sq43793911/Masterarbeit_public/README.md

# 硕士论文

# 高速切削加工中基于偏心误差影响的铣削刀柄的实验和模拟模态分析

对高速切削加工中铣削刀柄的弯曲振动进行了模态分析，并分析了偏心误差对于结构固有频率的影响。通过学习非线性有限元的基本方法，提出了对于高速运动物体的模态分析的行之有效的方法，独立完成了非线性有限元的模态分析的建模，并学习了模态分析的实验研究方法和常用实验软件的使用方法。

仿真模型使用Matlab 进行构建，并与Ansys 结果进行比较分析。使用Solidworks 进行实验用零件的绘制，使用PULSE LabShop 和ME’scopeVES 进行实验的测量和分析。

# Masterarbeit an TU Freiberg

Experimentelle und simulative Modalanalyse eines Werkzeugschaftes beim HSC-Fräsen und Einfluss eines Exzentrizitätsfehlers.

# Aufgabenstellung: 

Im Rahmen der ausgeschriebenen Arbeit ist das dynamische Verhalten eines Werkzeugschaftes beim HSC-Fräsen zu untersuchen. Der Einfluss einer Unwucht (Exzentrizität) soll dabei im Vordergrund stehen. Neben der Simulation soll auch eine experimentelle Untersuchung erfolgen. Dazu ist eine Versuchsvorrichtung zu konstruieren, zu fertigen und in Betrieb zu nehmen.

# Teilaufgaben:

1. Einarbeitung in das Thema simulative und experimentelle Modalanalyse

2. Erstellung eines Programmes oder einer Berechnungsvorschrift zur simulativen Modalanalyse

3. Konstruktion, Fertigung und Inbetriebnahme eines Versuchsstandes zur experimentellen Modalanalyse

4. Schriftliche Dokumentation der Arbeit

5. Erstellung eines Poster zum Inhalt der Arbeit
