sq43793911/Masterarbeit_public/n.linear FEM/Schaft_10x8-Schaft_10x8_0N-1.docx

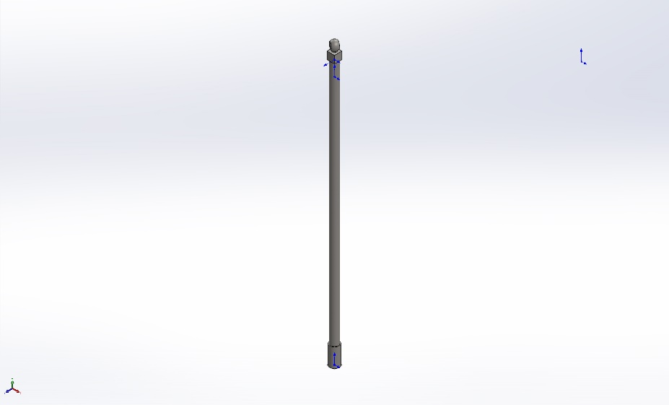
[picture p1: figure]

Simulation of Schaft_10x8

Date: 06.03.2020
Designer: Solidworks

Study name: Schaft_10x8_0N

Analysis type: Frequency
Description No Data

# Assumptions

# Model Information

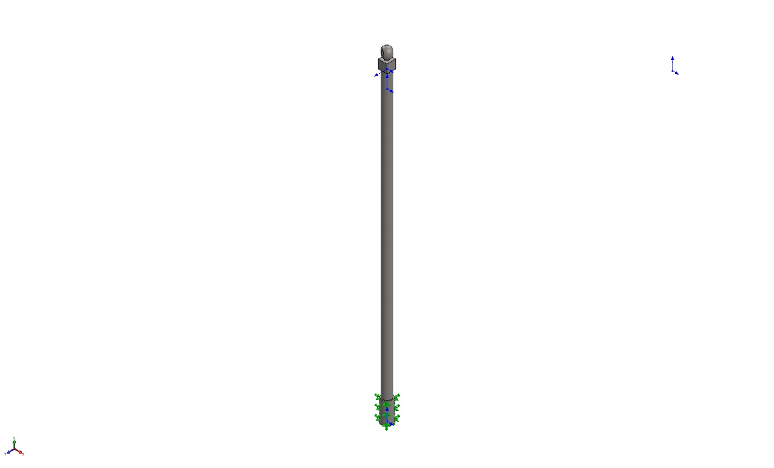
[picture p2: figure]

Model name: Schaft_10x8

Current Configuration: Default

Solid Bodies
Document Name and Reference | Treated As | Volumetric Properties | Document Path/Date Modified

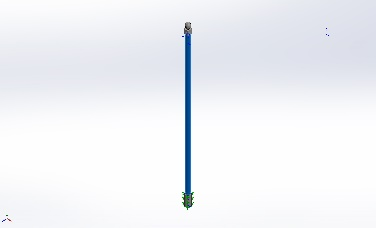
[picture p3: figure]

Aufsatz-Linear austragen1 | Solid Body | Mass:0.0727781 kg Volume:9.33053e-06 m^3 Density:7800 kg/m^3 Weight:0.713226 N | C:\Users\sq437\Desktop\Masterarbeit\BauV2018\Schaft Ra10mm Ri8mm.SLDPRT Mar 6 13:01:30 2020

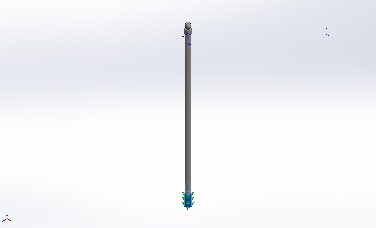
[picture p4: figure]

Rotation3 | Solid Body | Mass:0.0298954 kg Volume:3.83274e-06 m^3 Density:7800 kg/m^3 Weight:0.292975 N | C:\Users\sq437\Desktop\Masterarbeit\BauV2018\Stopfen Schaft Lagerung Var2.SLDPRT Mar 6 13:01:24 2020

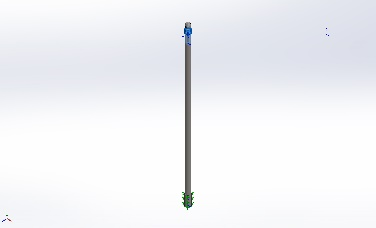
[picture p5: figure]

Cut-Extrude1 | Solid Body | Mass:0.0110468 kg Volume:1.41626e-06 m^3 Density:7800 kg/m^3 Weight:0.108259 N | C:\Users\sq437\Desktop\Masterarbeit\BauV2018\Stopfen Schaft Ringschraube Var2 ohne schrauben.SLDPRT Mar 6 13:09:47 2020

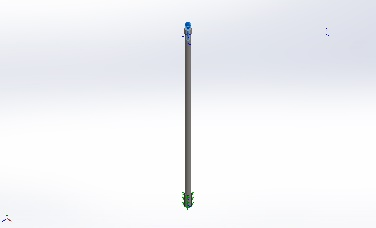
[picture p6: figure]

Fillet1 | Solid Body | Mass:0.00792918 kg Volume:1.09368e-06 m^3 Density:7250 kg/m^3 Weight:0.077706 N | C:\SOLIDWORKS Data\browser\DIN\bolts and screws\miscellaneous\eyebolt_din.sldprt Mar 6 12:38:14 2020

# Study Properties

Study name | Schaft_10x8_0N
Analysis type | Frequency
Mesh type | Solid Mesh
Number of frequencies | 5
Solver type | FFEPlus
Soft Spring: | Off
Incompatible bonding options | Automatic
Thermal option | Include temperature loads
Zero strain temperature | 298 Kelvin
Include fluid pressure effects from SOLIDWORKS Flow Simulation | Off
Result folder | SOLIDWORKS document (C:\Users\sq437\Desktop\Masterarbeit\BauV2018)

# Units

Unit system: | SI (MKS)
Length/Displacement | mm
Temperature | Kelvin
Angular velocity | Rad/sec
Pressure/Stress | N/m^2

# Material Properties

Model Reference | Properties | Components

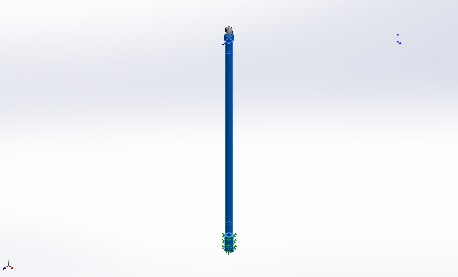
[picture p7: figure]

| Name: 1.0114 (S235J0) Model type: Linear Elastic Isotropic Default failure criterion: Max von Mises Stress Yield strength: 2.35e+08 N/m^2 Tensile strength: 3.6e+08 N/m^2 Mass density: 7800 kg/m^3 Elastic modulus: 2.1e+11 N/m^2 Poisson's ratio: 0.28 Thermal expansion coefficient: 1.1e-05 /Kelvin | SolidBody 1(Aufsatz-Linear austragen1)(Schaft Ra10mm Ri8mm-1), SolidBody 1(Rotation3)(Stopfen Schaft Lagerung Var2-1), SolidBody 1(Cut-Extrude1)(Stopfen Schaft Ringschraube Var2 ohne schrauben-1)

Curve Data:N/A

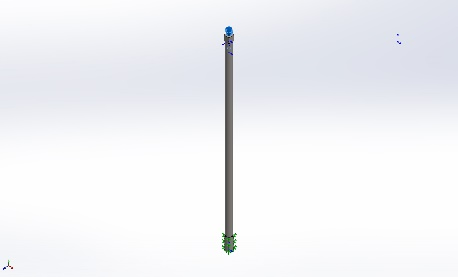
[picture p8: figure]

| Name: 1.0420 (G200) Model type: Linear Elastic Isotropic Default failure criterion: Max von Mises Stress Yield strength: 2e+08 N/m^2 Tensile strength: 3.8e+08 N/m^2 Mass density: 7250 kg/m^3 Elastic modulus: 2.1e+11 N/m^2 Poisson's ratio: 0.26 Thermal expansion coefficient: 1.15e-05 /Kelvin | SolidBody 1(Fillet1)(eyebolt_din-1)

Curve Data:N/A

# Loads and Fixtures

Fixture name | Fixture Image | Fixture Details

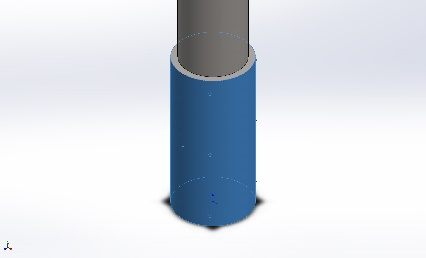
[picture p9: figure]

Fixed-1 | | Entities: 1 face(s) Type: Fixed Geometry

# Connector Definitions

No Data

# Contact Information

Contact | Contact Image | Contact Properties

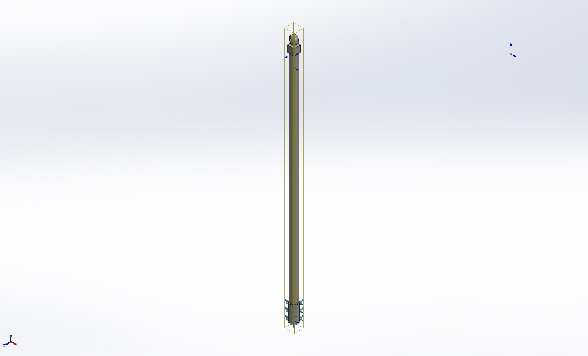
[picture p10: figure]

Global Contact | | Type: Bonded Components: 1 component(s) Options: Compatible mesh

# Mesh information

Mesh type | Solid Mesh
Mesher Used: | Standard mesh
Automatic Transition: | Off
Include Mesh Auto Loops: | Off
Jacobian points | 4 Points
Element Size | 1.51045 mm
Tolerance | 0.0755227 mm
Mesh Quality Plot | High
Remesh failed parts with incompatible mesh | Off

## Mesh information - Details

Total Nodes | 69886
Total Elements | 38733
Maximum Aspect Ratio | 9.0152
% of elements with Aspect Ratio < 3 | 99.2
% of elements with Aspect Ratio > 10 | 0
% of distorted elements(Jacobian) | 0
Time to complete mesh(hh;mm;ss): | 00:00:10
Computer name: | QX2021

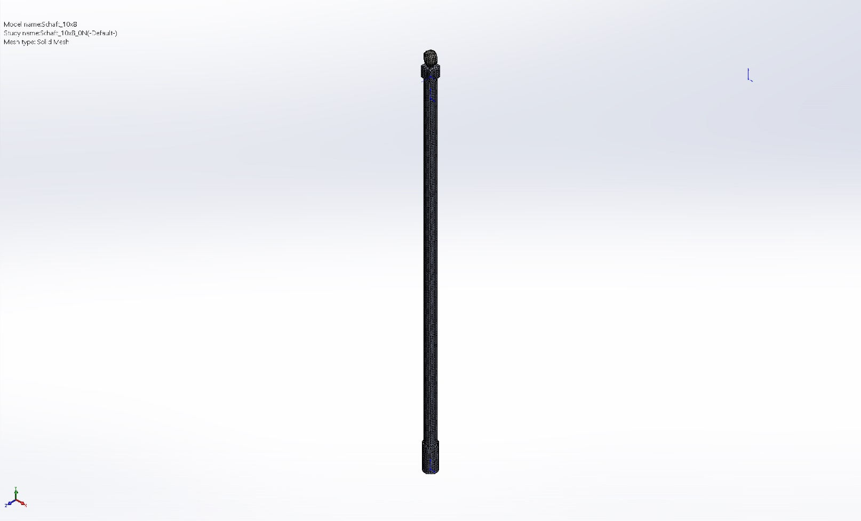
[picture p11: figure]

# Sensor Details

No Data

# Study Results

Name | Type | Min | Max
Amplitude1 | AMPRES: Resultant Amplitude Plot for Mode Shape: 1(Value = 61.0264 Hz) | 0.000e+00 Node: 51152 | 5.742e+00 Node: 66273

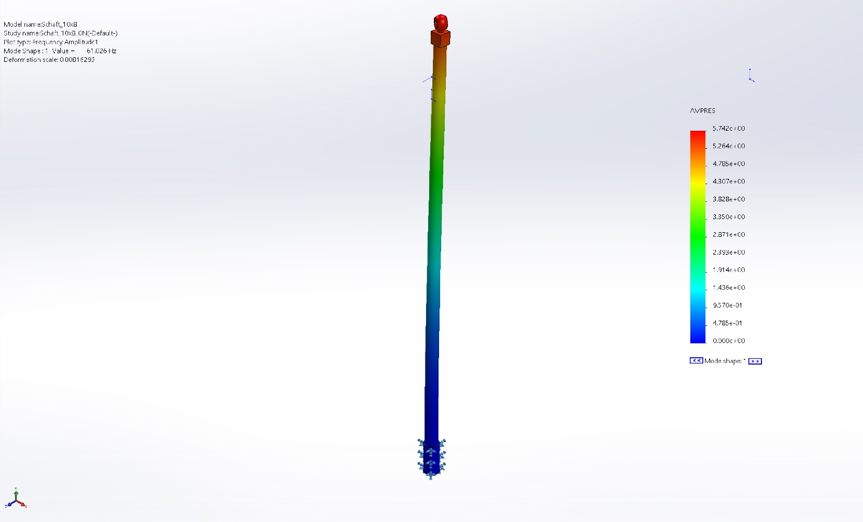
[picture p12: figure]

Schaft_10x8-Schaft_10x8_0N-Amplitude-Amplitude1

Name | Type | Min | Max
Amplitude2 | AMPRES: Resultant Amplitude Plot for Mode Shape: 2(Value = 61.0279 Hz) | 0.000e+00 Node: 51152 | 5.742e+00 Node: 66273

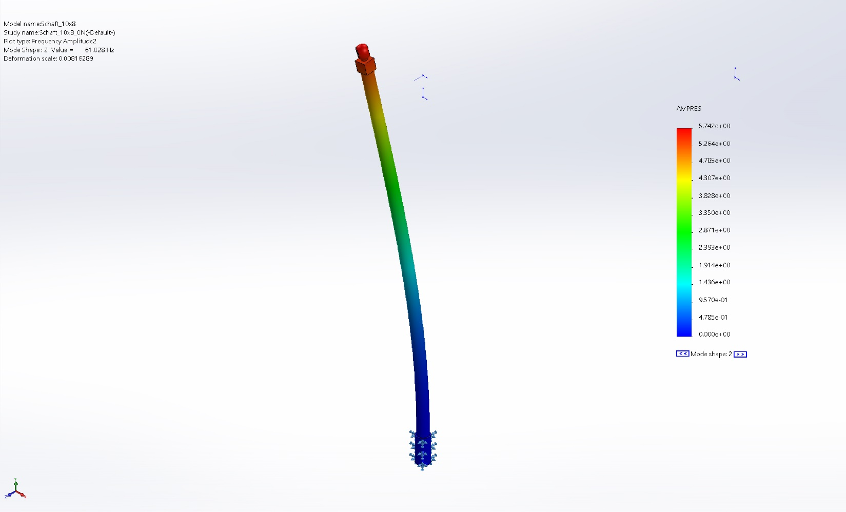
[picture p13: figure]

Schaft_10x8-Schaft_10x8_0N-Amplitude-Amplitude2

Name | Type | Min | Max
Amplitude3 | AMPRES: Resultant Amplitude Plot for Mode Shape: 3(Value = 433.234 Hz) | 0.000e+00 Node: 51152 | 5.274e+00 Node: 5956

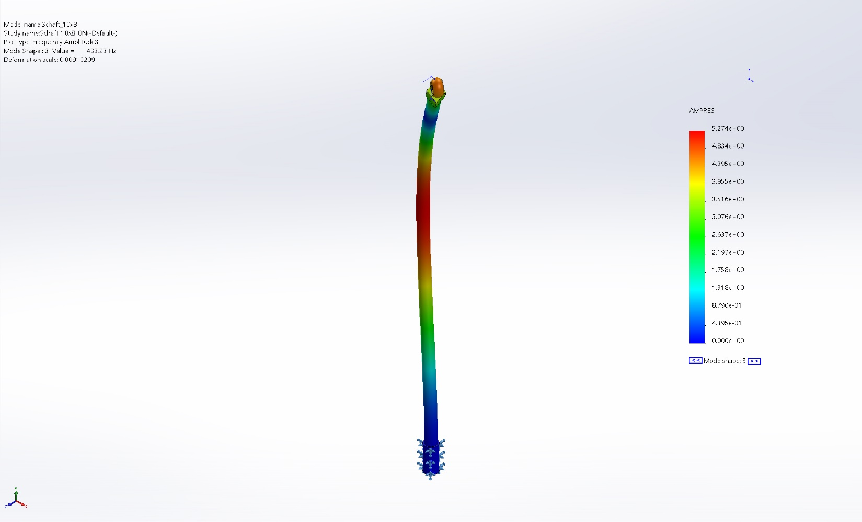
[picture p14: figure]

Schaft_10x8-Schaft_10x8_0N-Amplitude-Amplitude3

Name | Type | Min | Max
Amplitude4 | AMPRES: Resultant Amplitude Plot for Mode Shape: 4(Value = 433.275 Hz) | 0.000e+00 Node: 51152 | 5.274e+00 Node: 19951

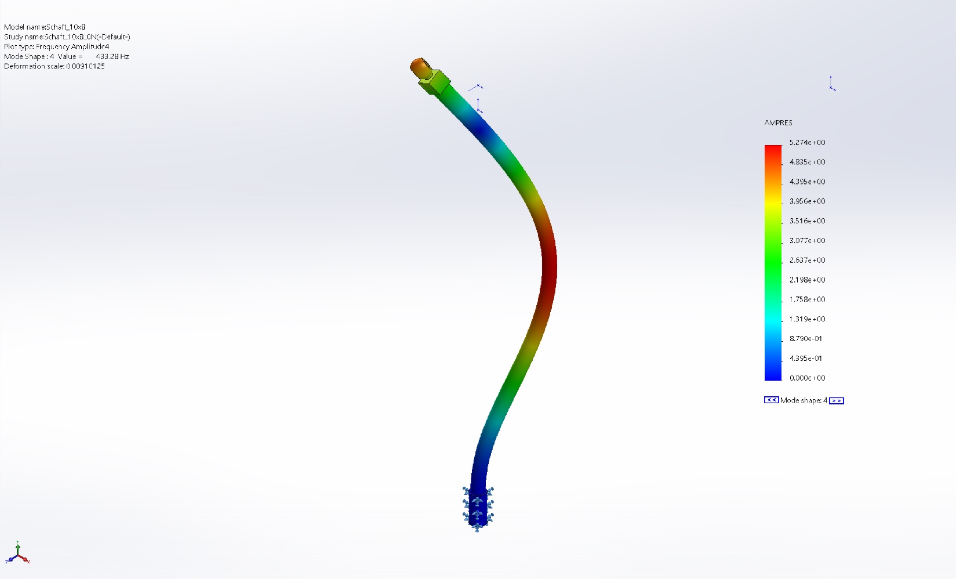
[picture p15: figure]

Schaft_10x8-Schaft_10x8_0N-Amplitude-Amplitude4

Name | Type | Min | Max
Amplitude5 | AMPRES: Resultant Amplitude Plot for Mode Shape: 5(Value = 1255.37 Hz) | 0.000e+00 Node: 51152 | 5.496e+00 Node: 21955

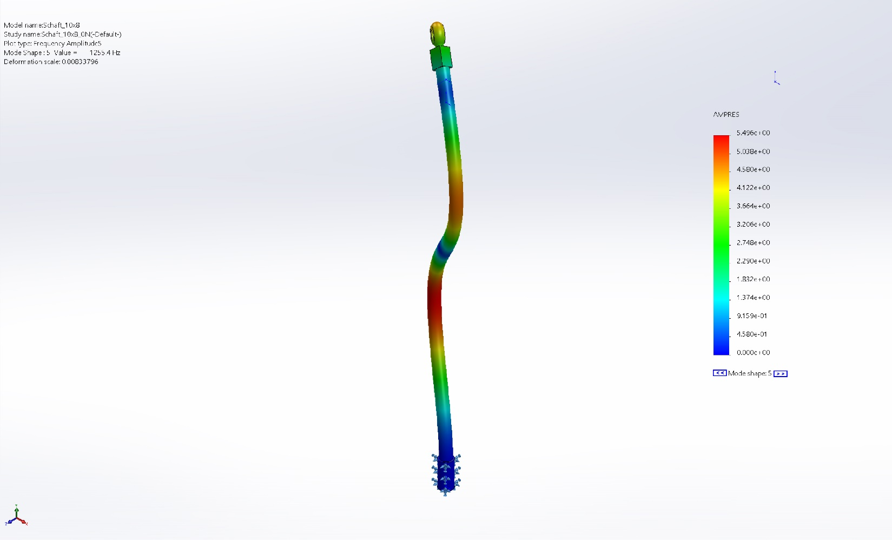
[picture p16: figure]

Schaft_10x8-Schaft_10x8_0N-Amplitude-Amplitude5

Mode List

Frequency Number | Rad/sec | Hertz | Seconds
1 | 383.44 | 61.026 | 0.016386
2 | 383.45 | 61.028 | 0.016386
3 | 2722.1 | 433.23 | 0.0023082
4 | 2722.3 | 433.28 | 0.002308
5 | 7887.7 | 1255.4 | 0.00079658

Mass Participation (Normalized)

Mode Number | Frequency(Hertz) | X direction | Y direction | Z direction
1 | 61.026 | 0.16961 | 4.6875e-15 | 0.31484
2 | 61.028 | 0.31484 | 2.3037e-13 | 0.16962
3 | 433.23 | 0.082575 | 3.0442e-12 | 0.050722
4 | 433.28 | 0.05072 | 2.3532e-13 | 0.082578
5 | 1255.4 | 0.031871 | 3.3202e-12 | 0.015023
| | Sum X = 0.64962 | Sum Y = 6.8348e-12 | Sum Z = 0.63278

# Conclusion

Analyzed with SOLIDWORKS Simulation Simulation of Schaft_10x8 2

Analyzed with SOLIDWORKS Simulation Simulation of Schaft_10x8 1
