sq43793911/Masterarbeit_public/Tex/Titlepage.tex

	\pagestyle{fancy}
	
	\begin{titlepage}
		
		% Erklärung %%%%%%%%%%%%%%%%%%%%%%%%%%%%%%%%%%%%%%%%%%%%%%%%%%%%%%%%%%%%%
		{\LARGE \textbf{Erklärung}}\\
		
		Hiermit versichere ich, die vorliegende Arbeit ohne Hilfe Dritter und nur mit den angegebenen
		Quellen und Hilfsmitteln angefertigt zu haben. Alle Stellen, die aus den Quellen entnommen
		wurden, sind als solche kenntlich gemacht worden. Diese Arbeit hat in gleicher oder ähnlicher
		Form noch keiner Prüfungsbehörde vorgelegen.\\
		\\
		\\
		\\
		\\
		Freiberg, den\underline{\quad \quad}.\underline{\quad \quad}.20\underline{\quad \quad}\\
		\\
		\\
		\\
		\underline{\qquad \qquad \qquad \qquad \qquad \quad} \\
		(Vorname Name)
		%%%%%%%%%%%%%%%%%%%%%%%%%%%%%%%%%%%%%%%%%%%%%%%%%%%%%%%%%%%%%%%%%%%%%%%%%%%%%%%%%%%%%%%%%%%%%%%%%%%
		
	\end{titlepage}
