sq43793911/Masterarbeit_public/Tex/Verzeichnis/Verzeichnis.tex

	\pagestyle{fancy}
	\section{Verzeichnis}
	\subsection{Quellenverzeichnis}
	%\nocite{*}
	\renewcommand\refname{\vskip -1cm}
	\bibliography{Masterarbeit}
	
	\subsection{Symbol- und Abkürzungsverzeichnis}
	
	\subsubsection*{Lateinische Notation}
	\begin{flalign*}
	& A       && \text{m}^{2}    && \text{Querschnittfläche}    && \\
%	& b       && \text{m}        && \text{Breit des Querschnitts}    && \\
%	& B       && \text{m}        && \text{Breit der Platte}    && \\
	& e       && \text{m}        && \text{Exzentrizitätsfehler} && \\
	& E       && \text{N}/\text{m}^{2} && \text{E-Modul} && \\
	& E_{kin} && \text{J}        && \text{kinetische Energie} && \\
	& E_{pot} && \text{J}        && \text{potentielle Energie} && \\
%	& f       && \mathrm{Hz}     && \text{Eigenfrequenz}    && \\
	& F       && \text{N}        && \text{Radialkraft}    && \\
	& Fx      && \text{N}        && \text{Zugkraft}    && \\
%	& h       && \text{m}        && \text{Höhe des Querschnitts}    && \\
	& H       && \text{m}        && \text{Übertragungsfunktion}    && \\
	& i       && -               && \text{Zählvariablen}    && \\
	& I       && \text{m}^{4}    && \text{Flächenträgheitsmoment}    && \\
	& I_{t}   && \text{m}^{4}    && \text{Torsionsträgheitsmoment} &&\\
	& L       && \text{m}        && \text{Länge des Schaftes}    && \\
	& l_{e}   && \text{m}        && \text{Länge eines Elements}    && \\
	& M_{b}   && \text{Nm}       && \text{Biegemoment}    && \\
	& t       && \text{s}        && \text{Zeit}    && \\
	& u       && \text{m}        && \text{Längsverschiebung in X-Richtung}    && \\
	& v       && \text{m}        && \text{Durchbiegung in Y-Richtung}    && \\
	& V		  && \text{m}^{3}    && \text{Volumen}    && \\
	& w       && \text{m}        && \text{Durchbiegung in Z-Richtung}    && \\
	& W		  && \text{J}        && \text{Formänderungsenergie}    && \\
	\end{flalign*}
	
	\subsubsection*{Griechische Notation}
	\begin{flalign*}
	& \varepsilon  && 1                       && \text{Dehnung}    && \\
	& \lambda      && -                       && \text{Eigenwert}    && \\
	& \nu          && 1                       && \text{Poissionzahl}    && \\
	& \rho         && \text{kg}/\text{m}^{3}  && \text{Dichte}    && \\
	& \phi         && 1 		              && \text{Verdrehung der Torsion}    &&\\
	& \varphi,\psi && 1 		              && \text{Biegewinkel}    &&\\
	& \Omega       && \text{rad/s} 		      && \text{Winkelgeschwindigkeit}    &&\\
	& \omega       && \text{1/s} 		      && \text{Kreisfrequenz}    &&\\
	\end{flalign*}

	\subsubsection*{Vektoren und Matrizen}
	\begin{flalign*}
	& \mathbf{D}      && \text{Dämpfungsmatrix}    && \\
	& \mathbf{D}_{e}  && \text{Dämpfungsmatrix eines Elements}    && \\
	& \vec{f}         && \text{Knotenkraftvektor}    && \\
	& \vec{f}_{e}     && \text{Knotenkraftvektor eines Elements}    && \\
	& \mathbf{K}      && \text{Steifigkeitsmatrix}    && \\
	& \mathbf{K}_{e}  && \text{Steifigkeitsmatrix eines Elements}    && \\
	& \mathbf{M}      && \text{Massenmatrix}    && \\
	& \mathbf{M}_{e}  && \text{Massenmatrix eines Elements}    && \\
	& \vec{N}         && \text{Vektor der Formfunktion}    && \\
%	& \vec{r}_{p}         && \text{Ortsvektor}    && \\
	& \mathbf{R}      && \text{Rotationsmatrix}    &&\\
	& \vec{x}         && \text{Knotenverschiebungsvektor}    && \\
	& \vec{x}_{e}         && \text{Knotenverschiebungsvektoreines Elements}    && \\
	\end{flalign*}
	
	\subsubsection*{Indices}
	\begin{flalign*}
	& ( \  )_{t} \ ; \ \dot{( \ )}                       && \text{Erste Ableitung nach der Zeit}    && \\
	& ( \ )_{tt} \ ; \ \ddot{( \ )}                      && \text{Zweite Ableitung nach der Zeit}    && \\
	& ( \ )^{\mathrm{T}}                                 && \text{Transposition der Matrix}    && \\
	& ( \ )_{x} \ ; \ ( \ )_{y} \ ; \ ( \ )_{z}      && \text{Erste Ableitung in Richtung X,Y,Z}    && \\
	& ( \ )_{xx} \ ; \ ( \ )_{yy} \ ; \ ( \ )_{zz}   && \text{Zweite Ableitung in Richtung X,Y,Z}    && \\
	\end{flalign*}
	
	\newpage
	
	\subsection{Abbildungsverzeichnis}
	\renewcommand\listfigurename{\vskip -1cm}
	\listoffigures
	
	\newpage
	
	\subsection{Tabellenverzeichnis}
	\renewcommand\listtablename{\vskip -1cm}
	\listoftables
