sq43793911/Masterarbeit_public/n.linear FEM/n.lin_langs_biege_torsion_drehen/IMG.PNG

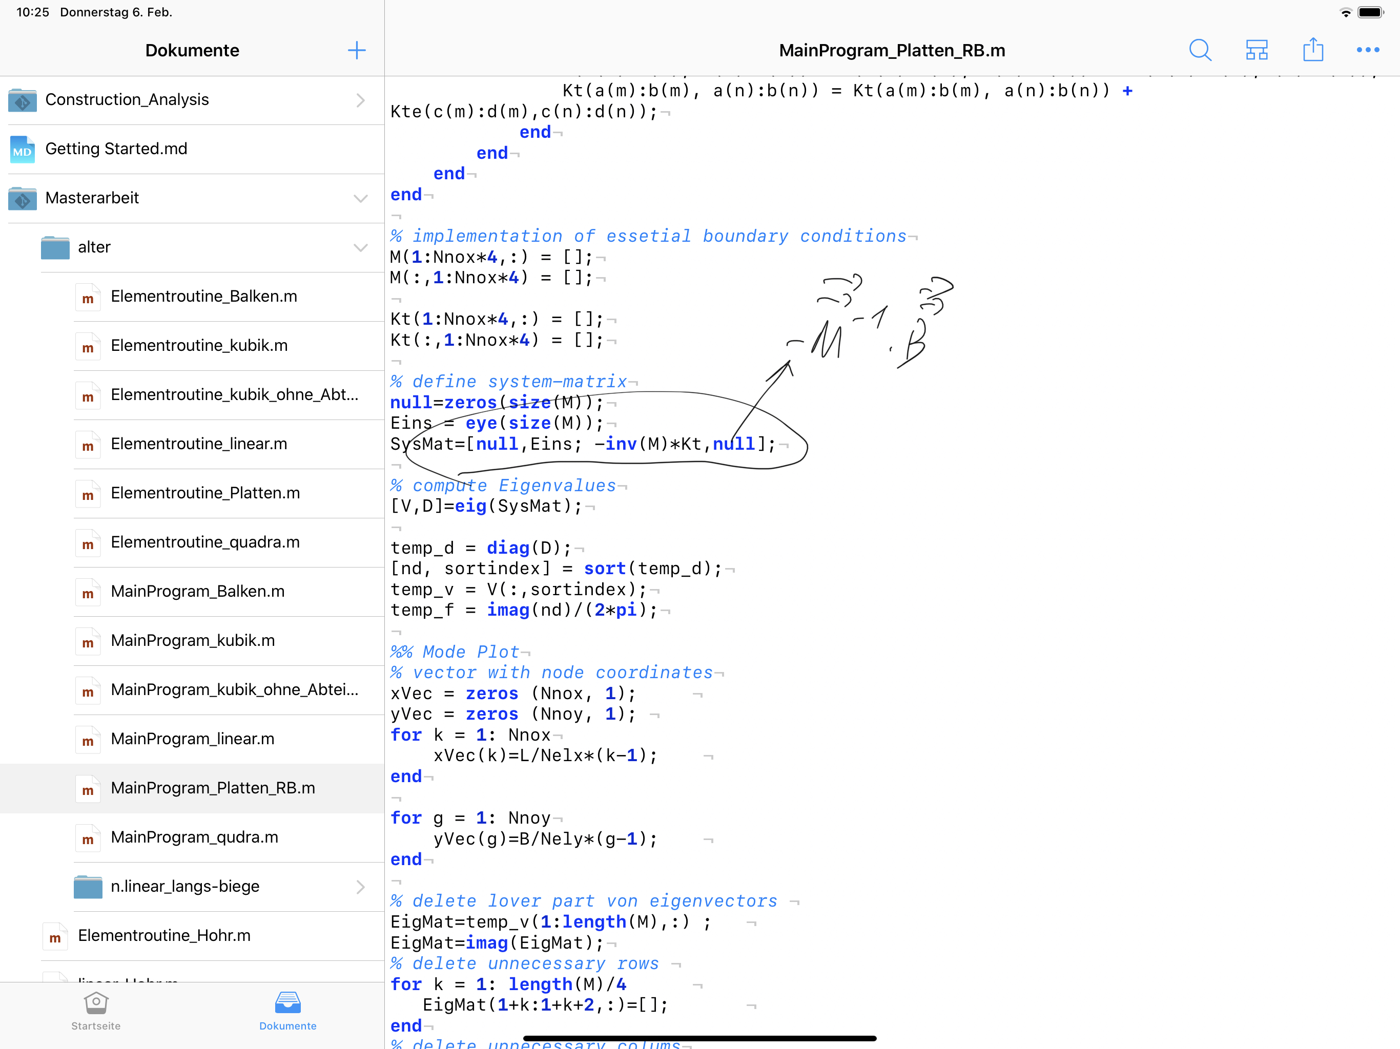
n.linear FEM/n.lin_langs_biege_torsion_drehen/IMG.PNG
