sq43793911/Masterarbeit_public/Solidworks/Schaft_10x8.SLDASM

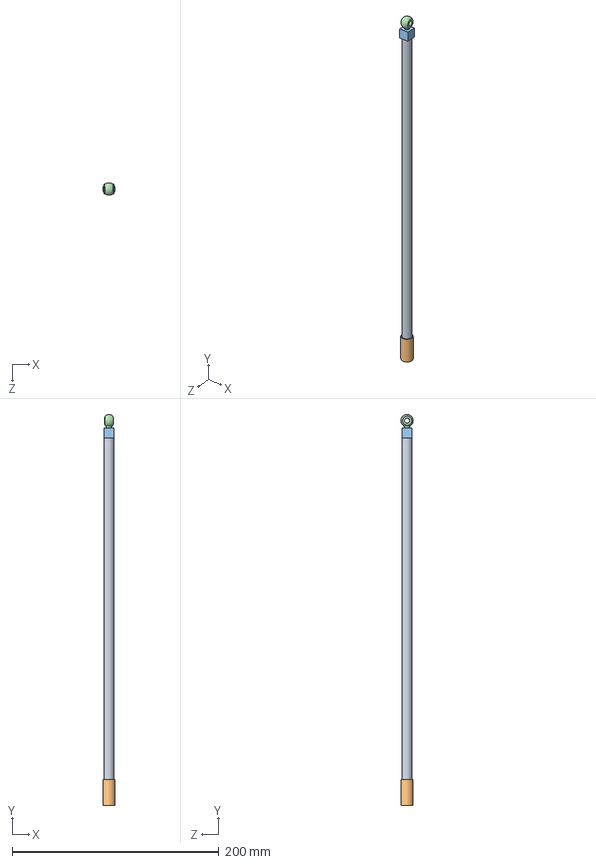
[picture p72: CAD file, 2020-08-10]
Solidworks/Schaft_10x8.SLDASM
12.0 x 377.9 x 12.0 mm
Schaft Ra10mm Ri8mm
Stopfen Schaft Lagerung Var2
Stopfen Schaft Ringschraube Var2 ohne schrauben
eyebolt_din
