sq43793911/Masterarbeit_public/Solidworks/Schaft_10x9_Ansys.SLDASM

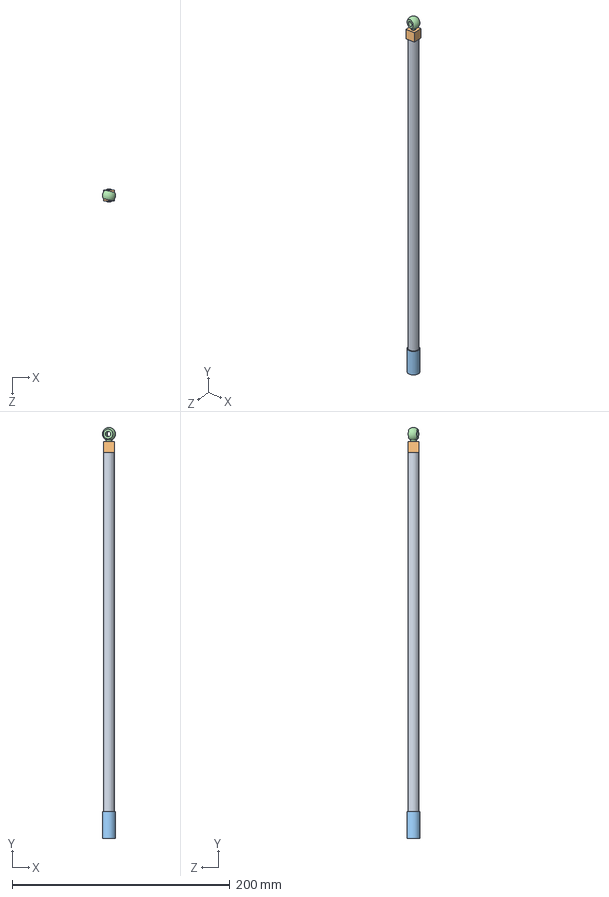
[picture p73: CAD file, 2020-08-10]
Solidworks/Schaft_10x9_Ansys.SLDASM
12.0 x 377.9 x 12.0 mm
Schaft Ra10mm Ri9mm
Stopfen Schaft Ringschraube
Stopfen Schaft Lagerung
eyebolt_din
