sq43793911/Masterarbeit_public/Solidworks/Stopfen Schaft Lagerung Var2.SLDPRT

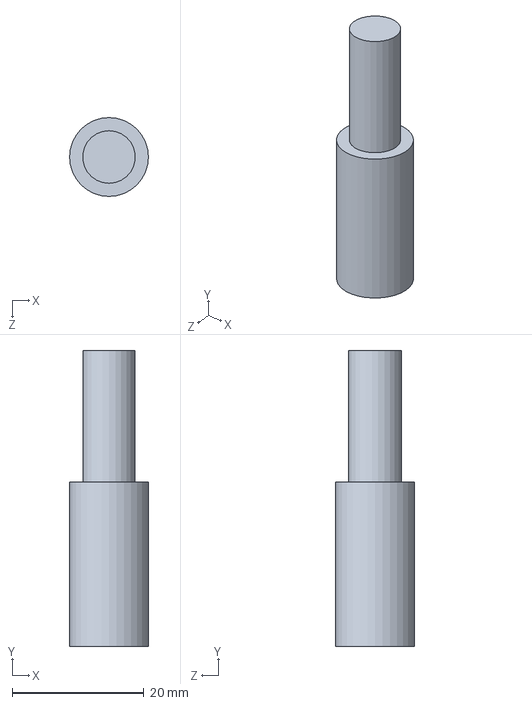
[picture p74: CAD file, 2020-08-10]
Solidworks/Stopfen Schaft Lagerung Var2.SLDPRT
12.0 x 45.0 x 12.0 mm
