sq43793911/Masterarbeit_public/Solidworks/Stopfen Schaft Ringschraube Var2 ohne schrauben.SLDPRT

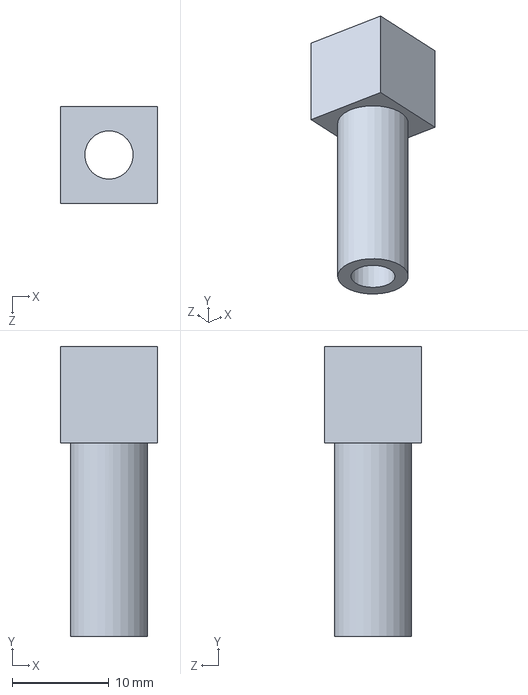
[picture p75: CAD file, 2020-08-10]
Solidworks/Stopfen Schaft Ringschraube Var2 ohne schrauben.SLDPRT
10.0 x 30.0 x 10.0 mm
