sq43793911/Masterarbeit_public/Solidworks/Stopfen Schaft Ringschraube_ohne_schrauben.SLDPRT

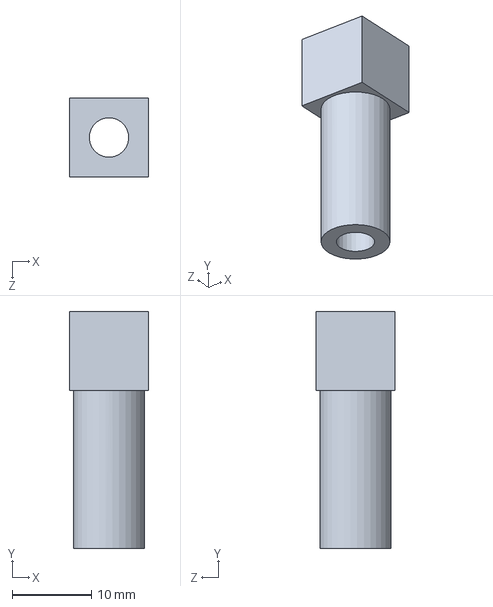
[picture p76: CAD file, 2020-08-10]
Solidworks/Stopfen Schaft Ringschraube_ohne_schrauben.SLDPRT
10.0 x 30.0 x 10.0 mm
