sq43793911/Masterarbeit_public/Solidworks/Schaft Ra10mm Ri9mm.SLDPRT

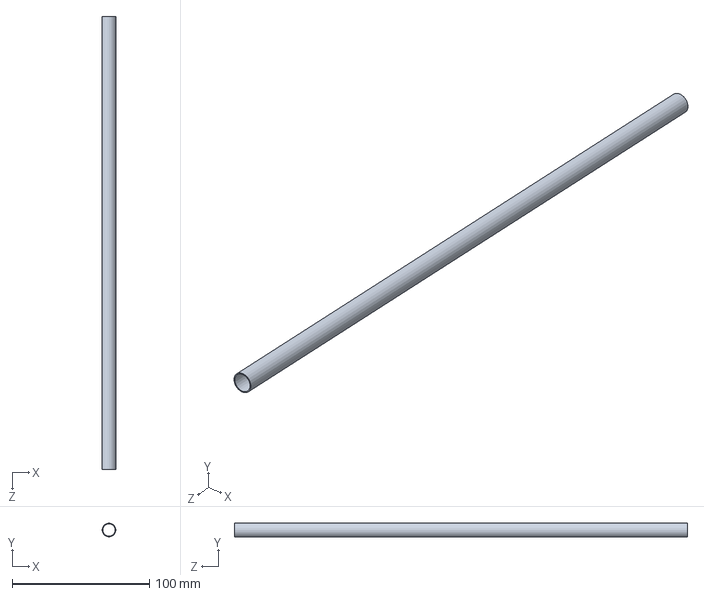
[picture p78: CAD file, 2020-08-10]
Solidworks/Schaft Ra10mm Ri9mm.SLDPRT
10.0 x 10.0 x 330.0 mm
