sq43793911/Masterarbeit_public/(list of files, cad)

Other CAD files:
Solidworks/Schaft_10x8_Ansys.SLDASM
Solidworks/Schaft_10x9.SLDASM
Solidworks/Stopfen Schaft Ringschraube Var2.SLDPRT
Solidworks/Stopfen Schaft Lagerung.SLDPRT
Solidworks/Stopfen Schaft Ringschraube.SLDPRT
Solidworks/Schaft_10x8.SLDDRW
