sq43793911/Masterarbeit_public/alter/n.linear_langs-biege/sta_mech_zug_biege_test_mk01-w.xlsx

Node | Value (mm) | X (mm) | Y (mm) | Z (mm)
3517 | 0 | 0 | -4.3301 | -2.5
3518 | 0 | 0 | -3.6369 | -3.4312
3519 | 0 | 0 | -2.7475 | -4.1774
3520 | 0 | 0 | -1.7101 | -4.6985
3521 | 0 | 0 | -0.58046 | -4.9662
3522 | 0 | 0 | 0.58046 | -4.9662
3523 | 0 | 0 | 1.7101 | -4.6985
3524 | 0 | 0 | 2.7475 | -4.1774
3525 | 0 | 0 | 3.6369 | -3.4312
3526 | 0 | 0 | 4.3301 | -2.5
5274 | 0 | 0 | 4.7899 | -1.434
5275 | 0 | 0 | 4.9915 | -0.29072
5276 | 0 | 0 | 4.924 | 0.86824
5277 | 0 | 0 | 4.5911 | 1.9804
5278 | 0 | 0 | 4.0106 | 2.9858
5279 | 0 | 0 | 3.2139 | 3.8302
5280 | 0 | 0 | 2.244 | 4.4682
5281 | 0 | 0 | 1.1531 | 4.8652
5282 | 0 | 0 | 0 | 5
7035 | 0 | 0 | -4.7899 | -1.434
7036 | 0 | 0 | -4.9915 | -0.29072
7037 | 0 | 0 | -4.924 | 0.86824
7038 | 0 | 0 | -4.5911 | 1.9804
7039 | 0 | 0 | -4.0106 | 2.9858
7040 | 0 | 0 | -3.2139 | 3.8302
7041 | 0 | 0 | -2.244 | 4.4682
7042 | 0 | 0 | -1.1531 | 4.8652
17561 | 0 | 0 | -1.7101 | 4.6985
17565 | 0 | 0 | -2.7475 | 4.1774
17570 | 0 | 0 | -3.6369 | 3.4312
17575 | 0 | 0 | -4.3301 | 2.5
17580 | 0 | 0 | -4.7899 | 1.434
17584 | 0 | 0 | -4.9915 | 0.29072
17587 | 0 | 0 | -4.924 | -0.86824
28063 | 0 | 0 | -0.58046 | 4.9662
28069 | 0 | 0 | 0.58046 | 4.9662
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
