sq43793911/Masterarbeit_public/n.linear FEM/Experiment/Ergebnissen von Rico.xlsx

10x8 [Hz] parallel | 0N | 1N | 1.5N | 2.5N | 5N | 7.5N | 10N
1. Mode | 52.9973 | 53.7662 | 53.9153 | 54.2713 | 54.6336 | 54.8047 | 55.0958
2. Mode | 397.111 | 396.462 | 396.441 | 396.133 | 396.537 | 396.516 | 396.293
3. Mode |  | 1156.86 | 1155.21 | 1155.88 | 1157.12 | 1156.54 | 1157.5
4. Mode
