sq43793911/Masterarbeit_public/n.linear FEM/Experiment/Ergebnissen_10_Mar.xlsx

10x8 [Hz] parallel | 0N | 2.5N | 3.25N | 5N | 5.75N | 8.25N | 15N | 20N | 25N
1. Mode | 48.4595 | 48.6722 | 48.7425 | 48.5692 | 48.6058 | 48.688
2. Mode | 337.597 | 336.852 | 338.304 | 334.5842 | 335.221 | 336.35
3. Mode | 732.094 | 717.818 | 735.453 | 696.037 | 702.69 | 715.221
4. Mode | 1213.04 | 1192.84 | 1212.27 | 1168.21 | 1176.17 | 1191.29
senkrecht | 0N | 2.5N | 3.25N | 5N | 5.75N | 8.25N | 15N | 20N | 25N
1. Mode | 51.56 | 48.7906 | 51.4042 | 49.6569 | 51.2527 | 54.9197
2. Mode | 396.245 | 396.558 | 397.419 | 395.22 | 396.201 | 397.169
3. Mode | 726.567 | 714.763(854.956) | 732.236(858.49) | 691.452(852.481) | 699.629(852.486) | 711.592(852.7)
4. Mode | 1217.04 | 1204.53 | 1154.29(1231.93) | 1179.01 | 1151.21(1190.51) | 1152.28
