sq43793911/Masterarbeit_public/n.linear FEM/Experiment/Ergebnissen_18_Mar.xlsx

10x9 [Hz] parallel | 0N | 2.5N | 5N | 7.5N | 10N
1. Mode | 39.1626 | 39.9271 | 40.7768 | 40.8399 | 40.9174
2. Mode | 335.391 | 348.715 | 350.367 | 352.775 | 353.809
3. Mode | 674.737 | 720.474 | 679.144 | 710.786 | 722.157
4. Mode | 1134.14 | 1151.29 | 1158.37 | 1190.01 | 1208.05
senkrecht
1. Mode |  | 41.8164 | 42.5501 | 43.3636 | 43.7239
2. Mode |  | 392.582 | 396.704 | 398.392 | 399.733
3. Mode |  | 690.618(860.557) | 672.472 | 706.531 | 718.185(871.447)
4. Mode |  | 1149.18 | 1168.48 | 1162.09 | 1162.17
