sq43793911/Masterarbeit_public/n.linear FEM/Experiment/Ergebnissen_19_20_Feb.xlsx

10x8 [Hz] | 0N-parallel | 5N-parallel | 10N-parallel | 15N-parallel | 20N-parallel | 25N-parallel | 0N_senkrecht | 5N_senkrecht | 10N_senkrecht | 15N_senkrecht | 20N_senkrecht | 25N_senkrecht
1. Mode |  |  | 49.9297 | 50.0103 | 51.3085 | 52.0745 | 54.0691 | 59.2734 | 55.3657 | 54.6128 | 54.8782 | 53.7259
2. Mode |  |  | 338.881 | 337.157 | 340.759 | 343.938 | 394.88 | 394.996 | 395.712 | 387.053 | 395.01 | 389.143
3. Mode |  |  | 750.436 | 747.026 | 751.493 | 755.049 | 725,718(834,967) | 732,828(836,257) | 737,815(838,866) | 731,484(836,775) | 842.409 | 857.785
4. Mode |  |  | 1225.27 | 1225.45 | 1217.6 | 1221.34 | 1176.66 | 1176.87 | 1152,47(1242,62) | 1173.33 | 1147.03 | 1222.48
10x9 [Hz] | 0N-parallel | 5N-parallel | 10N-parallel | 15N-parallel | 20N-parallel |  | 0N_senkrecht | 5N_senkrecht | 10N_senkrecht | 15N_senkrecht | 20N_senkrecht
1. Mode | 32.9703 | 38.3476 | 38.6214 | 38.6535 | 38.6742 |  |  | 46.4421 | 44.3043 | 43.5904 | 42.8829
2. Mode | 346079 | 349.111 | 350.584 | 349.434 | 347.663 |  |  | 385.105 | 388.537 | 393.234 | 387.639
3. Mode | 719.534 | 714.486 | 715.743 | 707.203 | 659.555 |  |  | 703.631 | 853.637 | 847.835 | 651.315
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
