sq43793911/Masterarbeit_public/n.linear FEM/n.lin_langs_biege/n.l.sta_mech_test_mk01-v.xlsx

Node | Value (m) | X (m) | Y (m) | Z(m)
3517 | 0 | 0 | -0.0043301 | -0.0025
3518 | 0 | 0 | -0.0036369 | -0.0034312
3519 | 0 | 0 | -0.0027475 | -0.0041774
3520 | 0 | 0 | -0.0017101 | -0.0046985
3521 | 0 | 0 | -0.00058046 | -0.0049662
3522 | 0 | 0 | 0.00058046 | -0.0049662
3523 | 0 | 0 | 0.0017101 | -0.0046985
3524 | 0 | 0 | 0.0027475 | -0.0041774
3525 | 0 | 0 | 0.0036369 | -0.0034312
3526 | 0 | 0 | 0.0043301 | -0.0025
5274 | 0 | 0 | 0.0047899 | -0.001434
5275 | 0 | 0 | 0.0049915 | -0.00029072
5276 | 0 | 0 | 0.004924 | 0.00086824
5277 | 0 | 0 | 0.0045911 | 0.0019804
5278 | 0 | 0 | 0.0040106 | 0.0029858
5279 | 0 | 0 | 0.0032139 | 0.0038302
5280 | 0 | 0 | 0.002244 | 0.0044682
5281 | 0 | 0 | 0.0011531 | 0.0048652
5282 | 0 | 0 | 0 | 0.005
7035 | 0 | 0 | -0.0047899 | -0.001434
7036 | 0 | 0 | -0.0049915 | -0.00029072
7037 | 0 | 0 | -0.004924 | 0.00086824
7038 | 0 | 0 | -0.0045911 | 0.0019804
7039 | 0 | 0 | -0.0040106 | 0.0029858
7040 | 0 | 0 | -0.0032139 | 0.0038302
7041 | 0 | 0 | -0.002244 | 0.0044682
7042 | 0 | 0 | -0.0011531 | 0.0048652
17561 | 0 | 0 | -0.0017101 | 0.0046985
17565 | 0 | 0 | -0.0027475 | 0.0041774
17570 | 0 | 0 | -0.0036369 | 0.0034312
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
