sq43793911/Masterarbeit_public/Tex/Anhang/PDFs/Balken.PDF

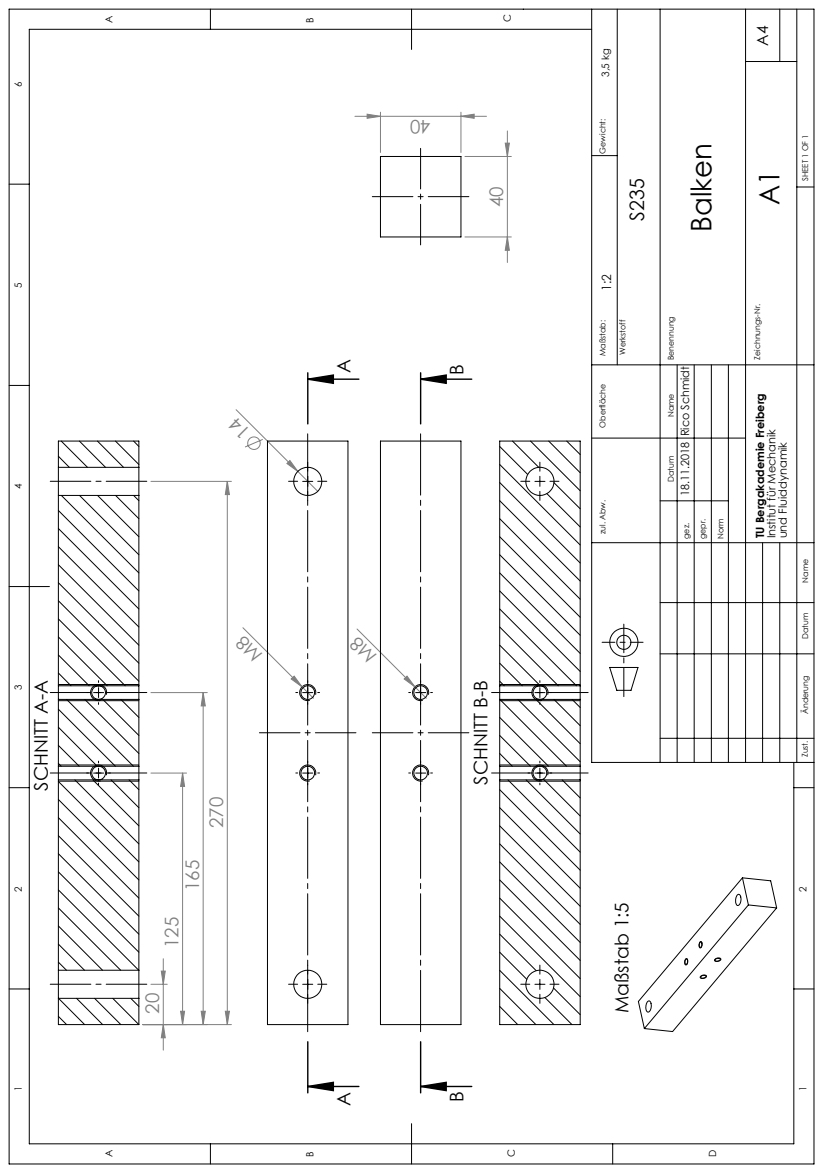
[picture p88: page 1]
SCHNITT A-A; SCHNITT B-B; Maßstab 1:5; Datum Name; SHEET 1 OF 1; Rico Schmidt 18.11.2018; und Fluiddynamik A1

3,5 kg Maßstab: Gewicht:

Oberfläche zul. Abw.

TU Bergakademie Freiberg

Institut für Mechanik
