sq43793911/Masterarbeit_public/Tex/Anhang/PDFs/Bodenplatte.PDF

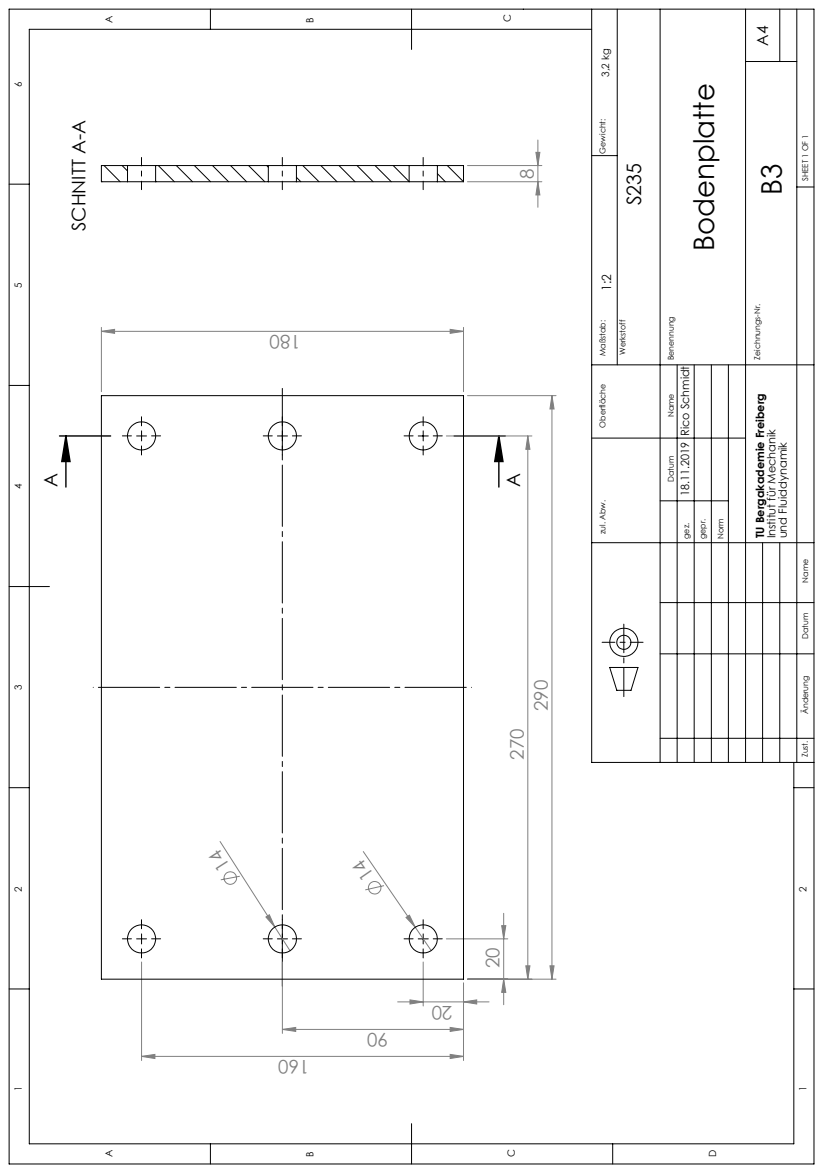
[picture p89: page 1]
SCHNITT A-A; Datum Name; SHEET 1 OF 1; Rico Schmidt 18.11.2019; und Fluiddynamik

3,2 kg Maßstab: Gewicht:

Oberfläche zul. Abw.

TU Bergakademie Freiberg

Institut für Mechanik
