sq43793911/Masterarbeit_public/Tex/Anhang/PDFs/Platte_Schlitten.PDF

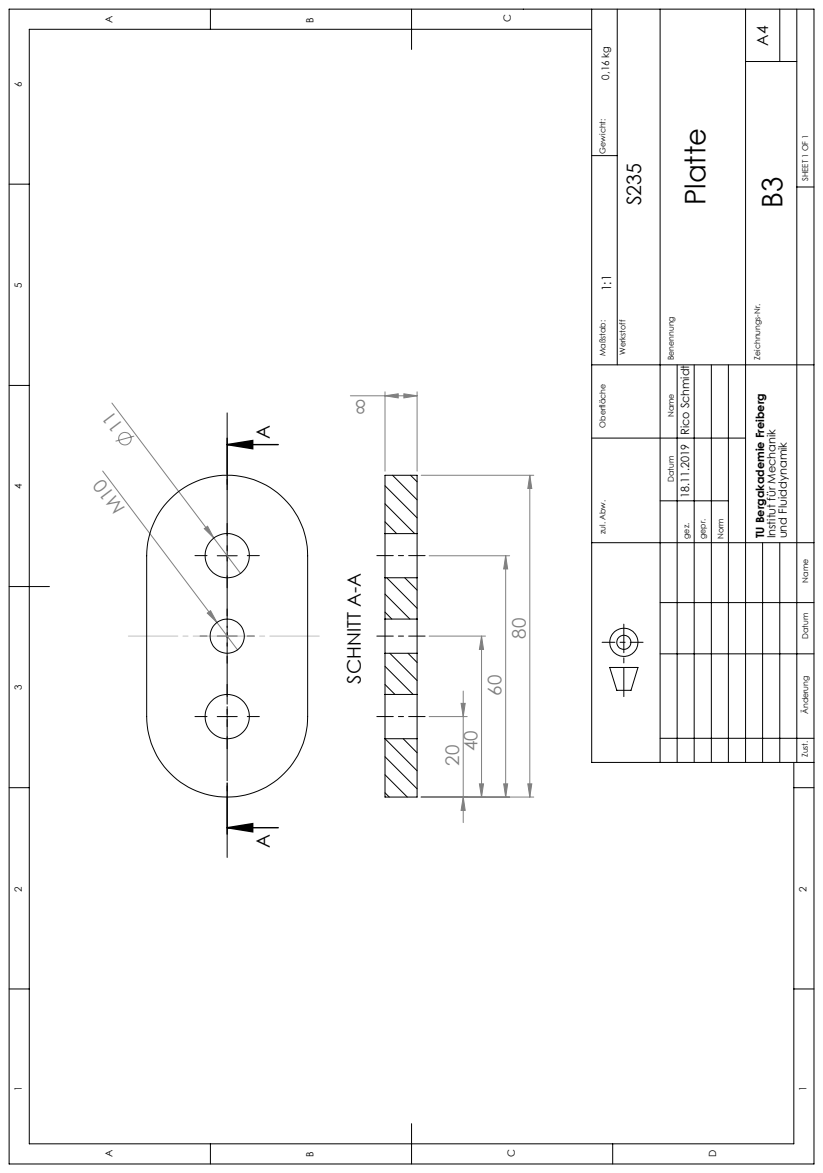
[picture p91: page 1]
SCHNITT A-A; Datum Name; SHEET 1 OF 1; Rico Schmidt 18.11.2019; und Fluiddynamik B3

0,16 kg Maßstab: Gewicht:

Oberfläche zul. Abw.

TU Bergakademie Freiberg

Institut für Mechanik
