sq43793911/Masterarbeit_public/Tex/Anhang/PDFs/Profil.PDF

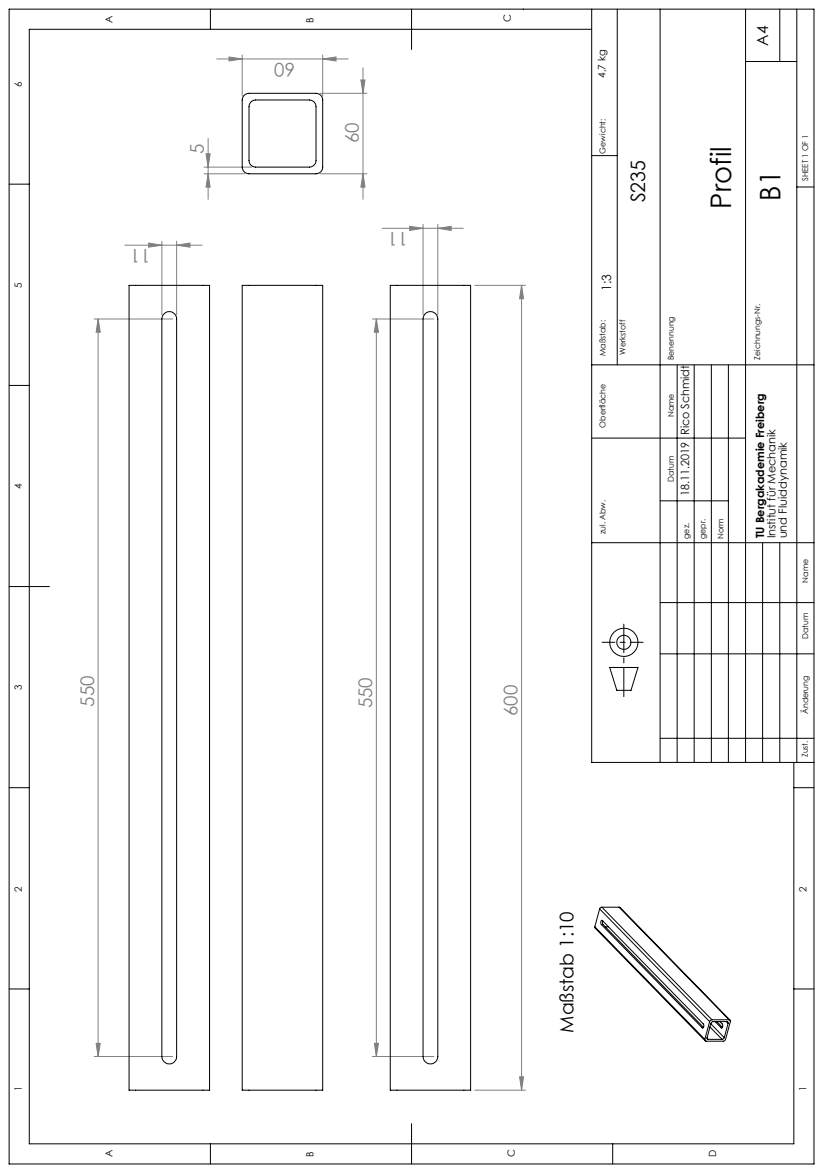
[picture p92: page 1]
Maßstab 1:10; Datum Name; SHEET 1 OF 1; Rico Schmidt 18.11.2019; und Fluiddynamik

4,7 kg Maßstab: Gewicht:

Oberfläche zul. Abw.

TU Bergakademie Freiberg

Institut für Mechanik
