sq43793911/Masterarbeit_public/Tex/Anhang/PDFs/Schaft_Ra10mm_Ri8mm.PDF

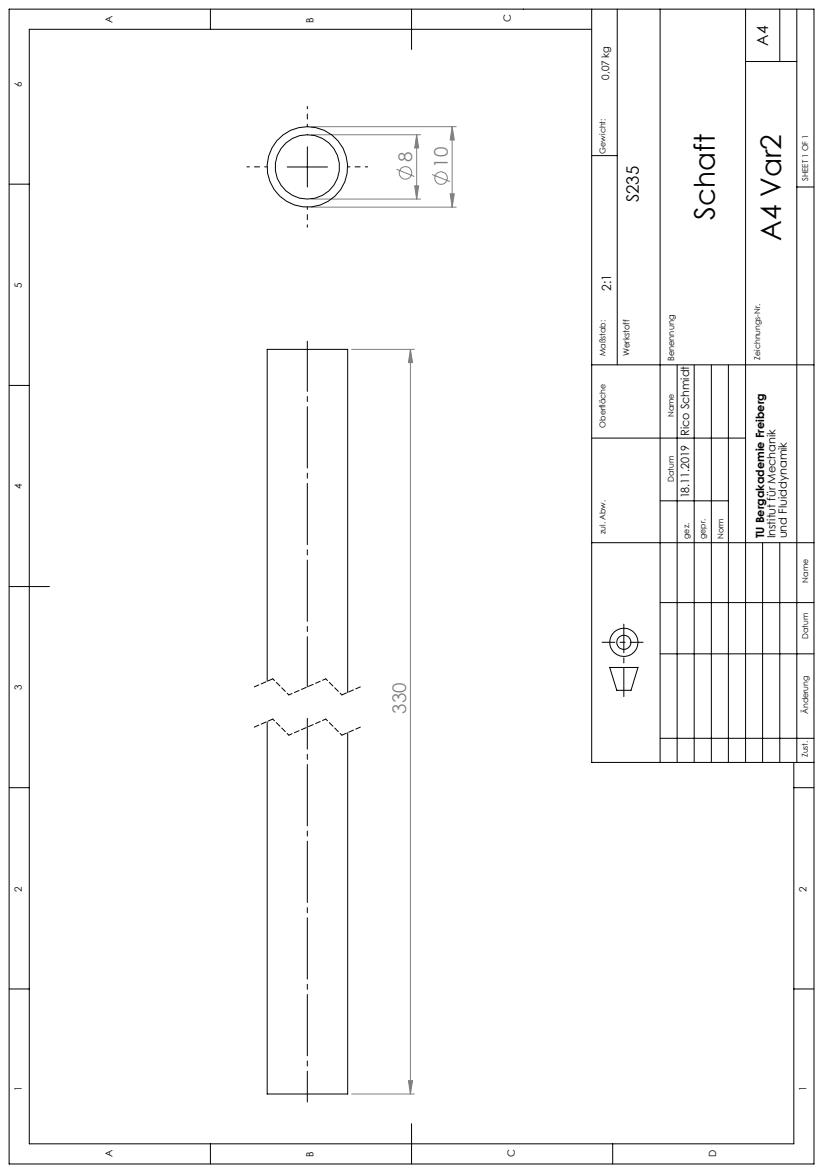
[picture p93: page 1]
Datum Name; SHEET 1 OF 1; Rico Schmidt 18.11.2019; und Fluiddynamik A4 Var2

0,07 kg Maßstab: Gewicht:

Oberfläche zul. Abw.

TU Bergakademie Freiberg

Institut für Mechanik
