sq43793911/Masterarbeit_public/Tex/Anhang/PDFs/Schaft_Ra10mm_Ri9mm.PDF

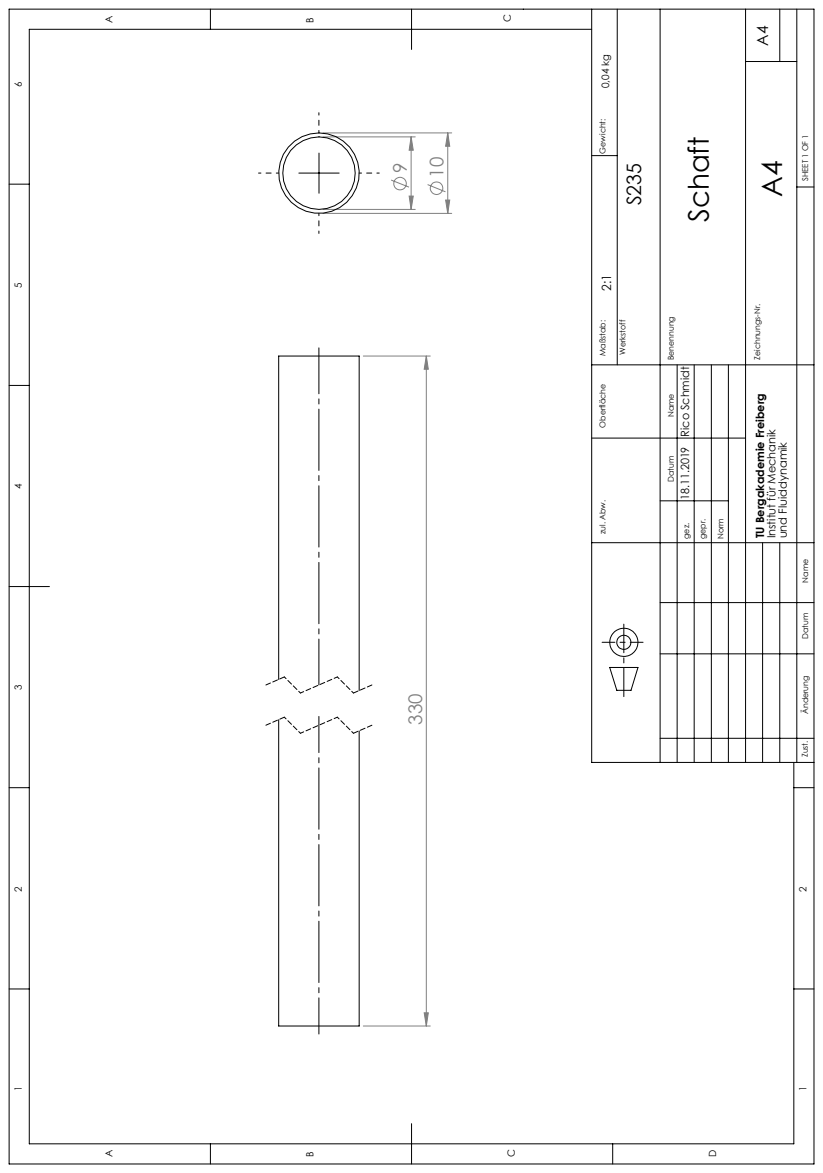
[picture p94: page 1]
Datum Name; SHEET 1 OF 1; Rico Schmidt 18.11.2019; und Fluiddynamik

0,04 kg Maßstab: Gewicht:

Oberfläche zul. Abw.

TU Bergakademie Freiberg

Institut für Mechanik
