sq43793911/Masterarbeit_public/Solidworks/Schaft Ra10mm Ri8mm.PDF

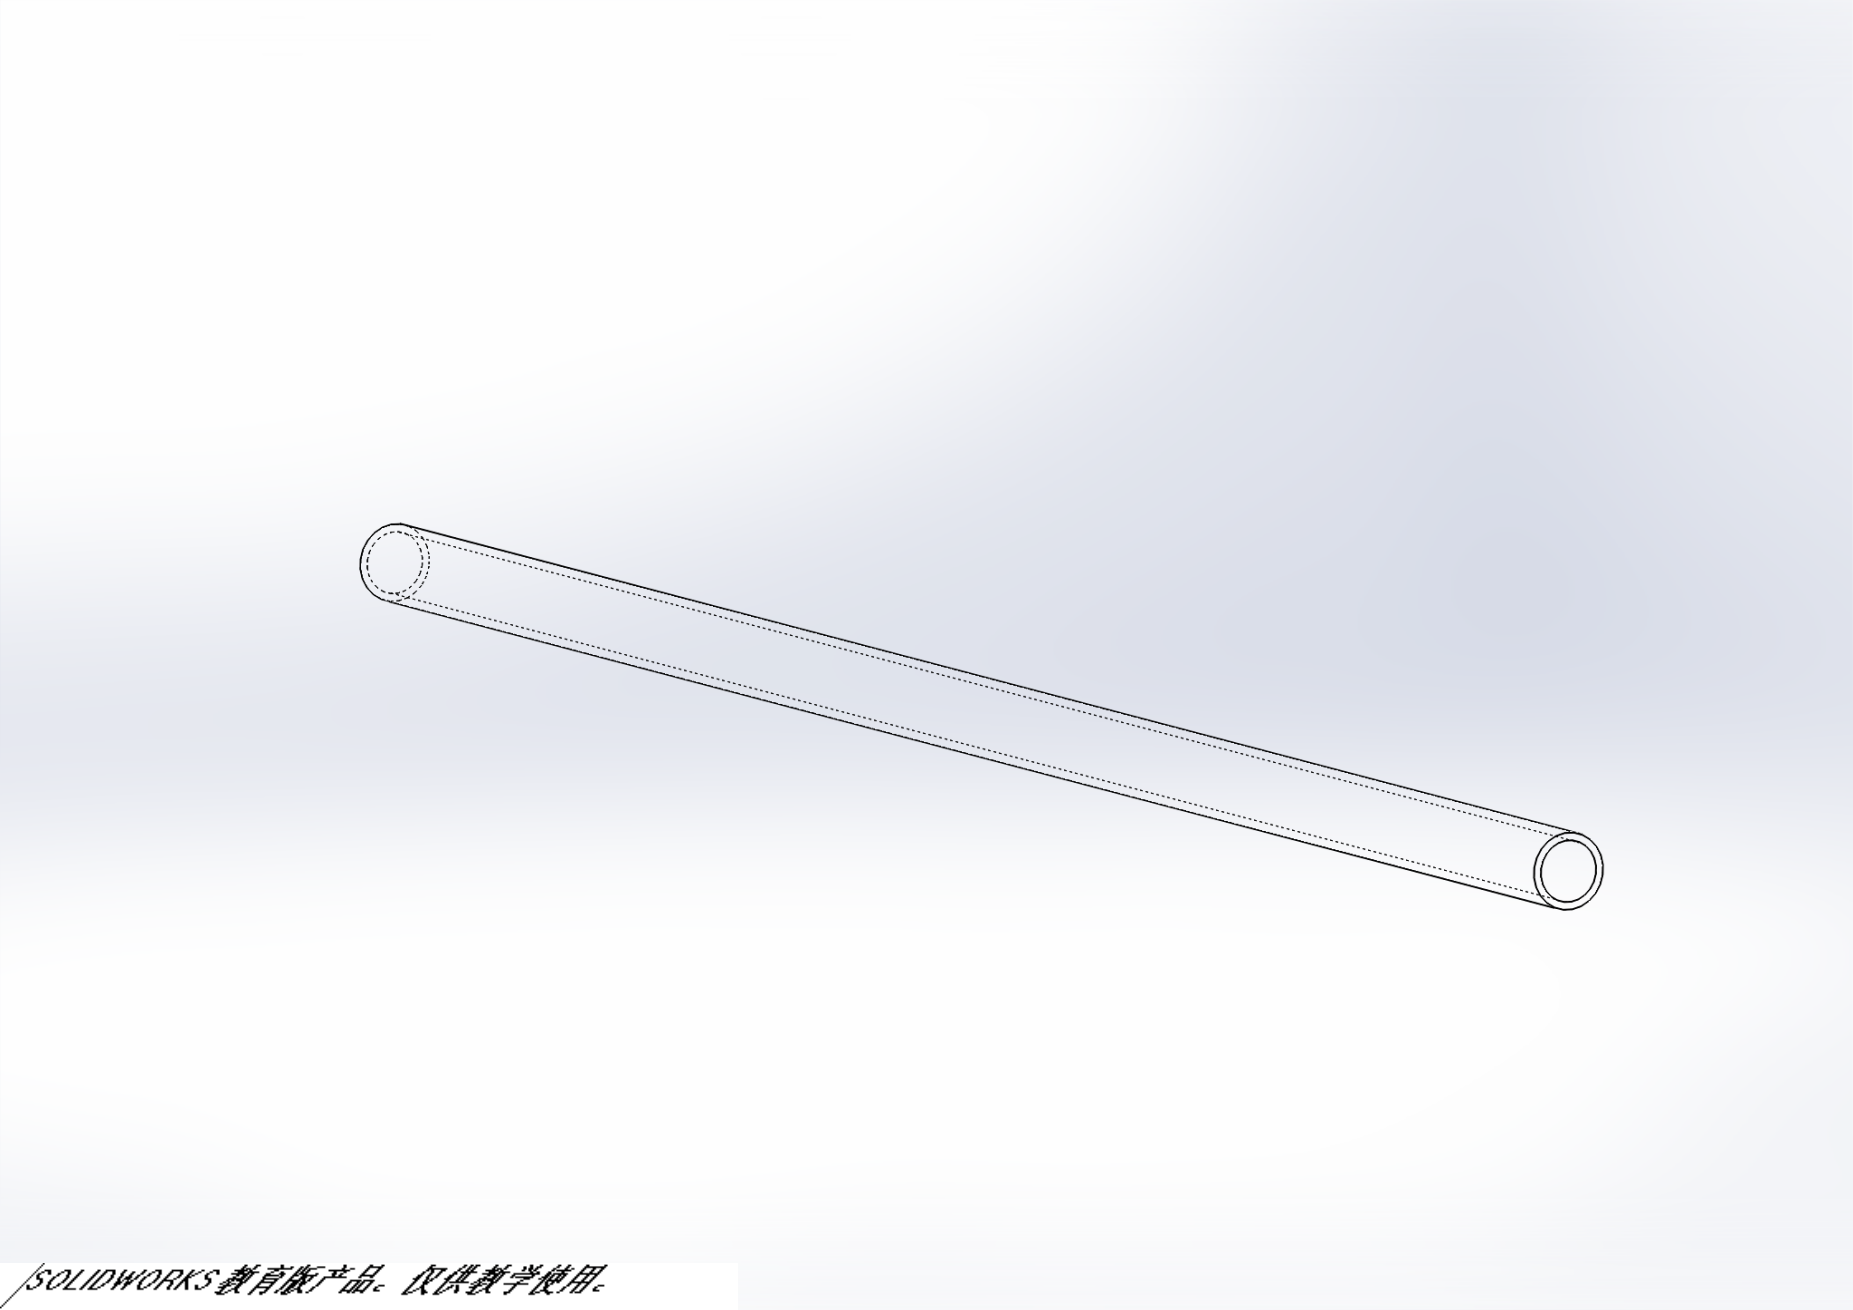
[picture p95: page 1]
