sq43793911/Masterarbeit_public/Tex/Anhang/PDFs/Baugruppe_Aufnahme.PDF

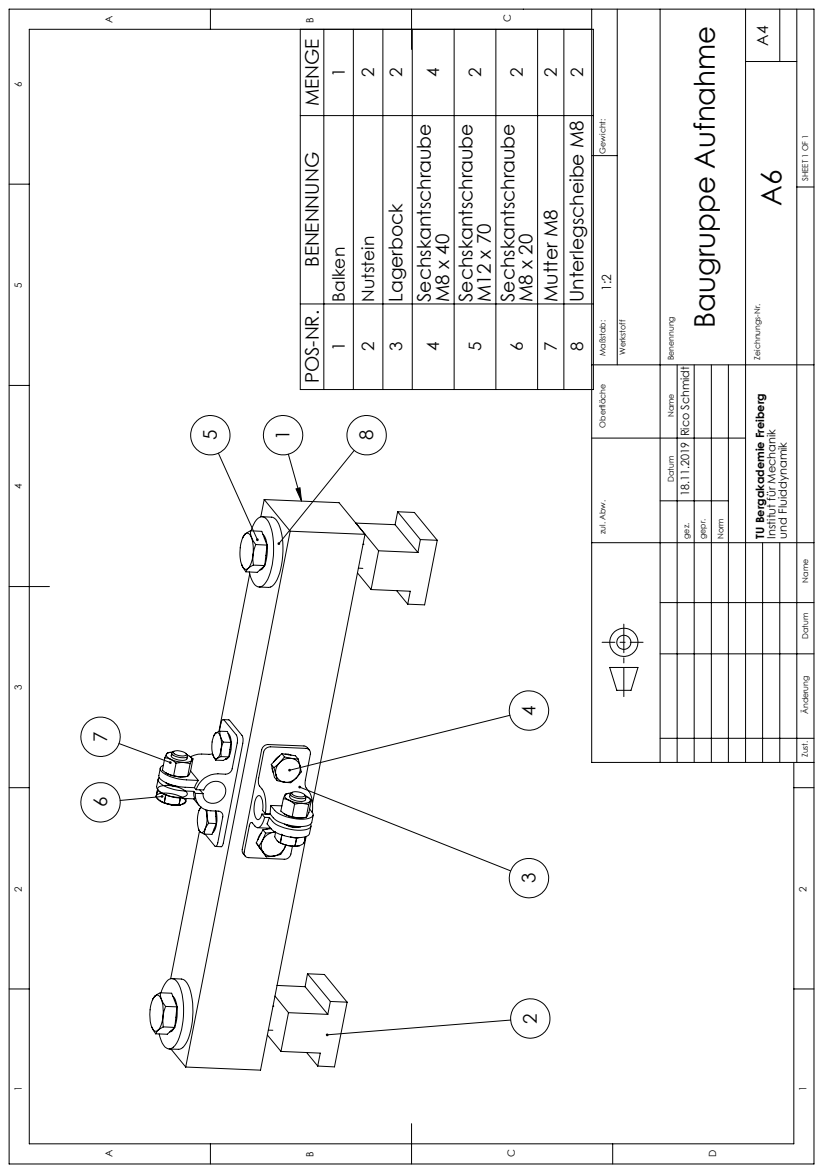
[picture p96: page 1]
1 Balken 1; 2 Nutstein 2; 3 Lagerbock 2; 4 Sechskantschraube; 5 Sechskantschraube; 6 Sechskantschraube; 7 Mutter M8 2; 8 Unterlegscheibe M8 2; Datum Name; SHEET 1 OF 1; Baugruppe Aufnahme; Maßstab: Gewicht:; Rico Schmidt 18.11.2019; und Fluiddynamik A6

POS-NR. BENENNUNG MENGE

Oberfläche zul. Abw.

TU Bergakademie Freiberg

Institut für Mechanik
