sq43793911/Masterarbeit_public/Tex/Anhang/PDFs/Baugruppe_Gegenkraft.PDF

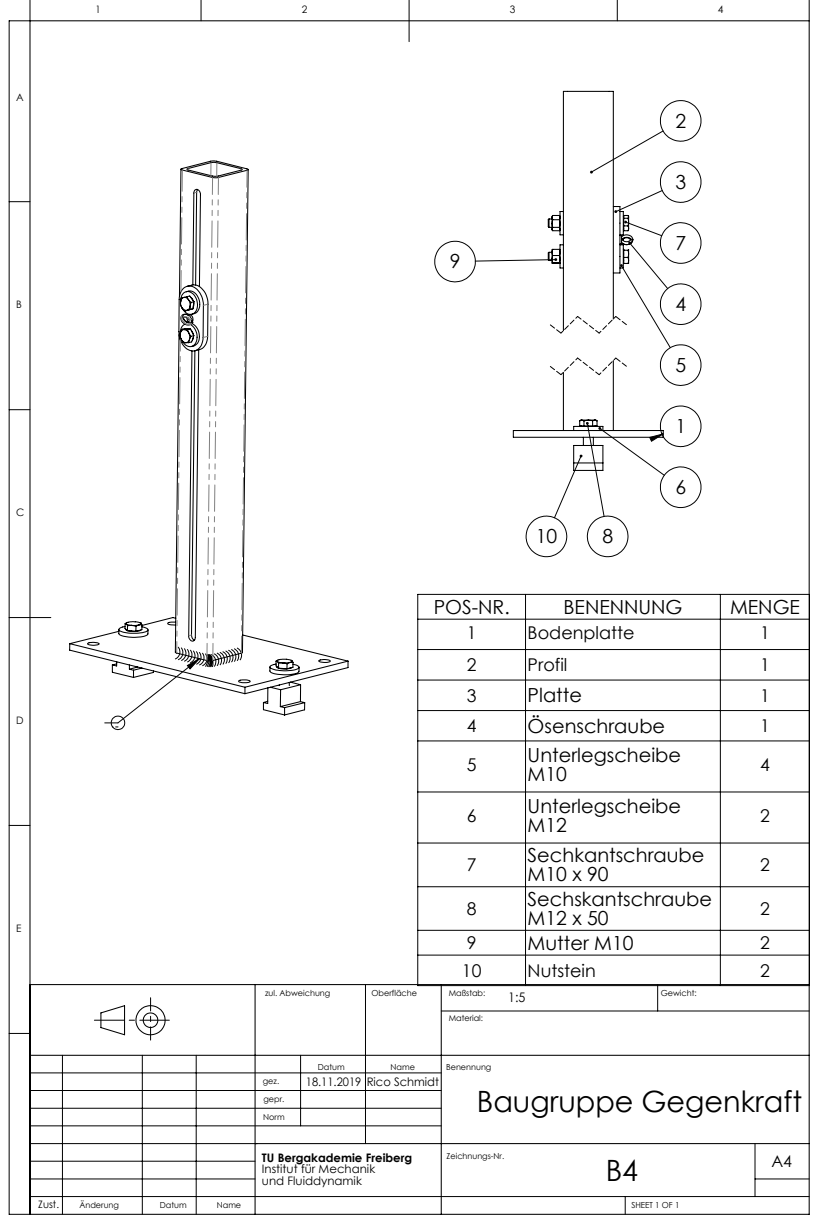
[picture p97: page 1]
Baugruppe Gegenkraft; zul. Abweichung; Gewicht:; SHEET 1 OF 1; Rico Schmidt; und Fluiddynamik

POS-NR. | BENENNUNG | MENGE
1 | Bodenplatte | 1
2 | Profil | 1
3 | Platte | 1
4 | Ösenschraube | 1
5 | Unterlegscheibe M10 | 4

6 | Unterlegscheibe M12 | 2
7 | Sechkantschraube M10 x 90 | 2
8 | Sechskantschraube M12 x 50 | 2
9 | Mutter M10 | 2
10 | Nutstein | 2

TU Bergakademie Freiberg
Institut für Mechanik
