sq43793911/Masterarbeit_public/Tex/Anhang/PDFs/Baugruppe_Gesamt.PDF

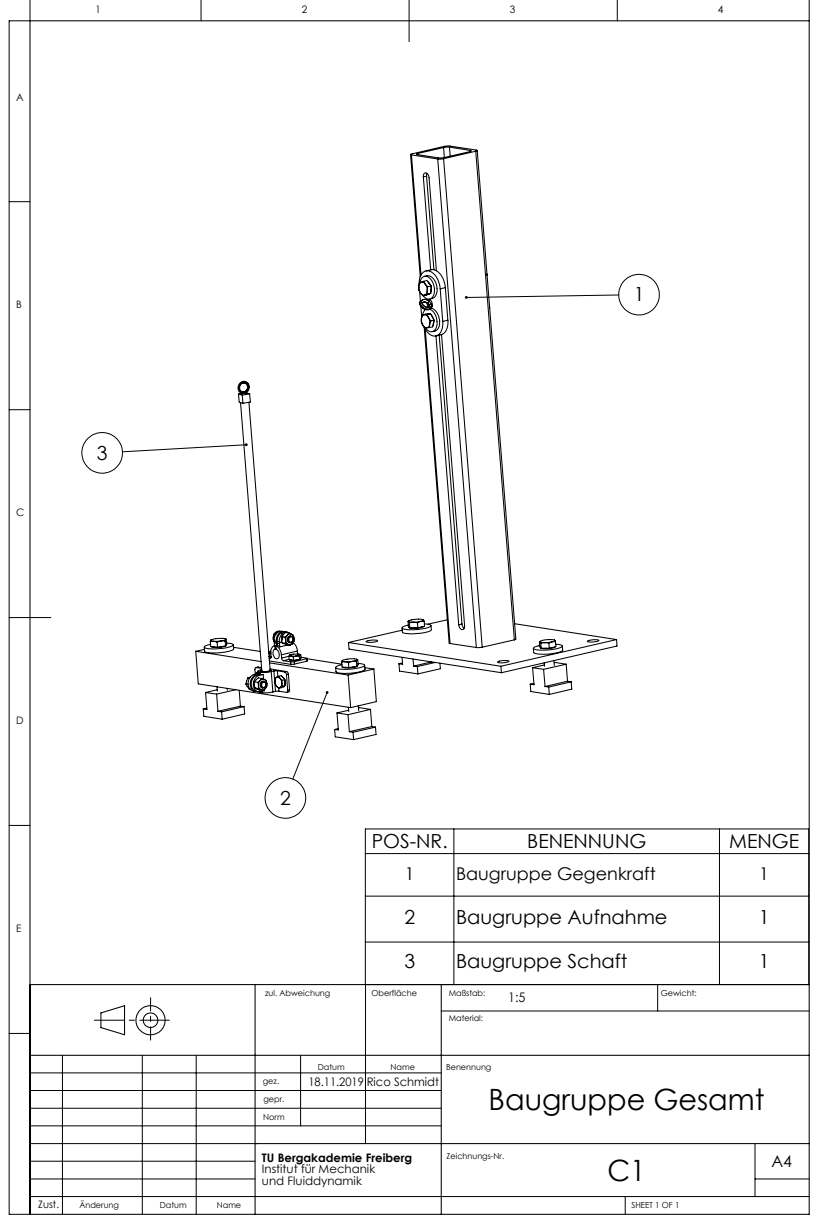
[picture p98: page 1]
Baugruppe Gesamt; zul. Abweichung; Gewicht:; SHEET 1 OF 1; 18.11.2019 Rico Schmidt; und Fluiddynamik

1 | Baugruppe Gegenkraft | 1
2 | Baugruppe Aufnahme | 1
3 | Baugruppe Schaft | 1

TU Bergakademie Freiberg
Institut für Mechanik
