sq43793911/Masterarbeit_public/Tex/Anhang/PDFs/Baugruppe_Schaft.PDF

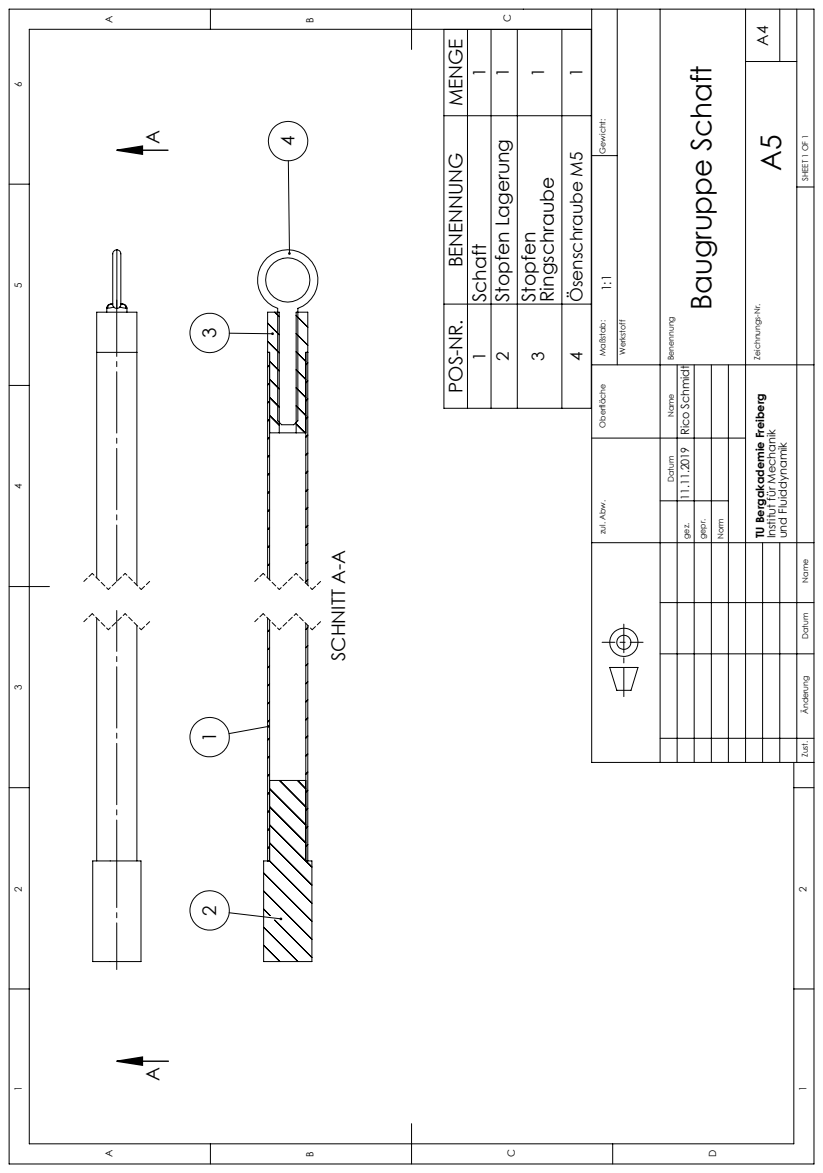
[picture p99: page 1]
SCHNITT A-A; 1 Schaft 1; 2 Stopfen Lagerung 1; 3 Stopfen; Ringschraube 1; 4 Ösenschraube M5 1; Datum Name; SHEET 1 OF 1; Baugruppe Schaft; Maßstab: Gewicht:; Rico Schmidt 11.11.2019; und Fluiddynamik A5

POS-NR. BENENNUNG MENGE

Oberfläche zul. Abw.

TU Bergakademie Freiberg

Institut für Mechanik
