sq43793911/Masterarbeit_public/Tex/Anhang/PDFs/Stopfen_Schaft_Lagerung.PDF

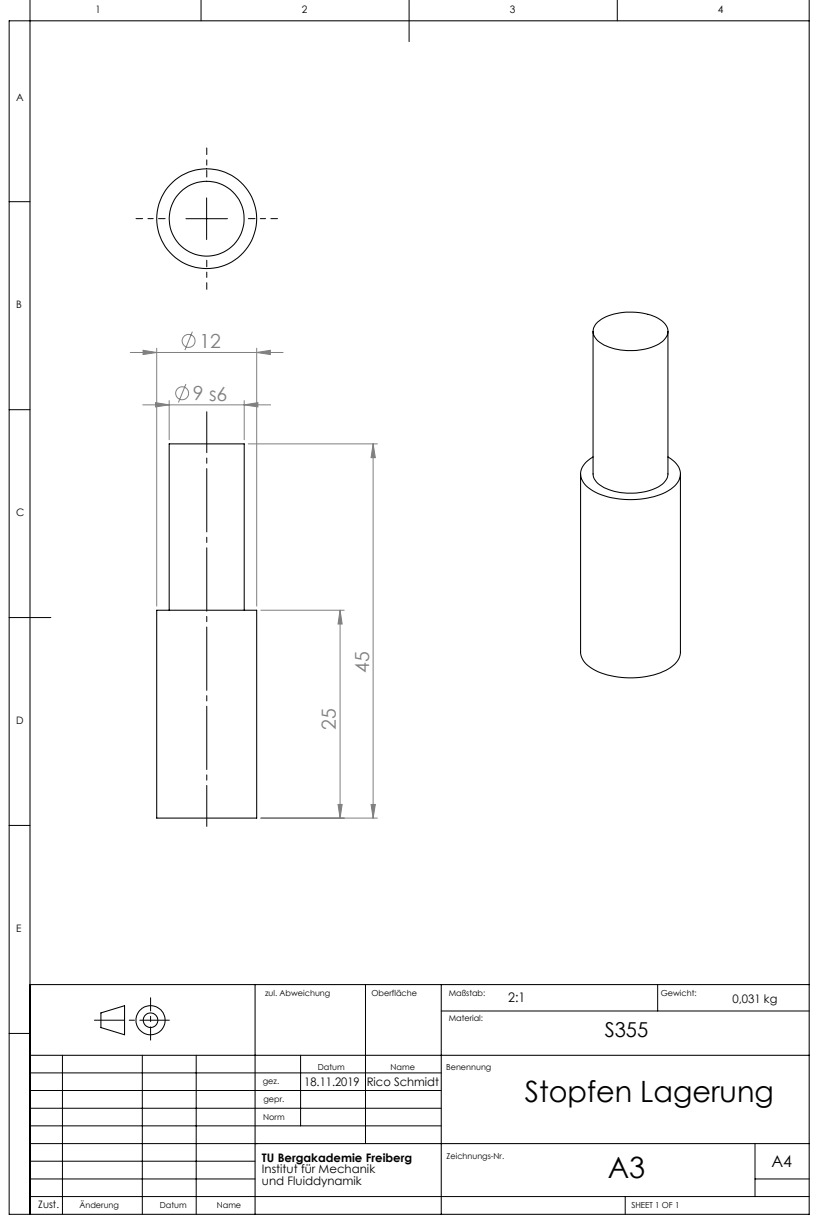
[picture p100: page 1]
Stopfen Lagerung; zul. Abweichung; Gewicht:; SHEET 1 OF 1; Rico Schmidt; und Fluiddynamik

TU Bergakademie Freiberg
Institut für Mechanik
