sq43793911/Masterarbeit_public/Tex/Anhang/PDFs/Stopfen_Schaft_Lagerung_Var2.PDF

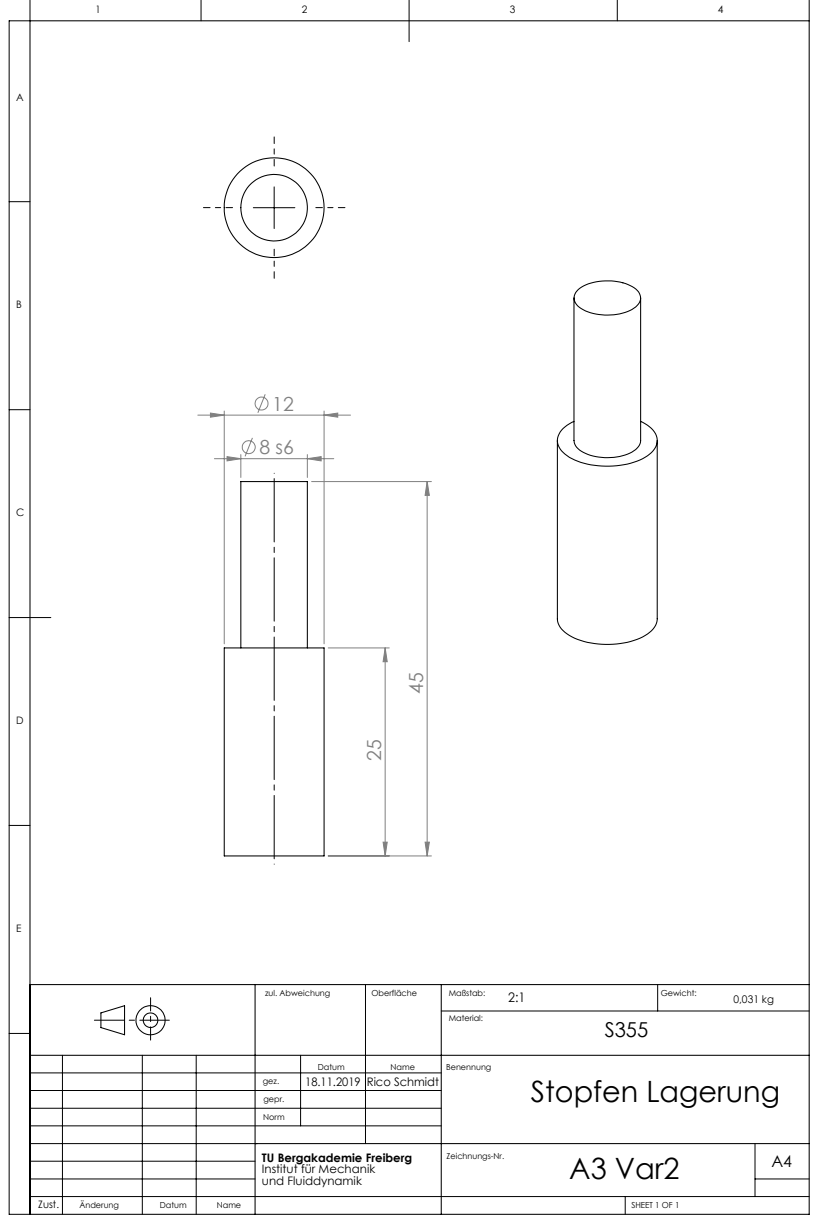
[picture p101: page 1]
A3 Var2; zul. Abweichung; Gewicht:; SHEET 1 OF 1; Rico Schmidt; Stopfen Lagerung

TU Bergakademie Freiberg
Institut für Mechanik
und Fluiddynamik
