sq43793911/Masterarbeit_public/Tex/Anhang/PDFs/Stopfen_Schaft_Ringschraube.PDF

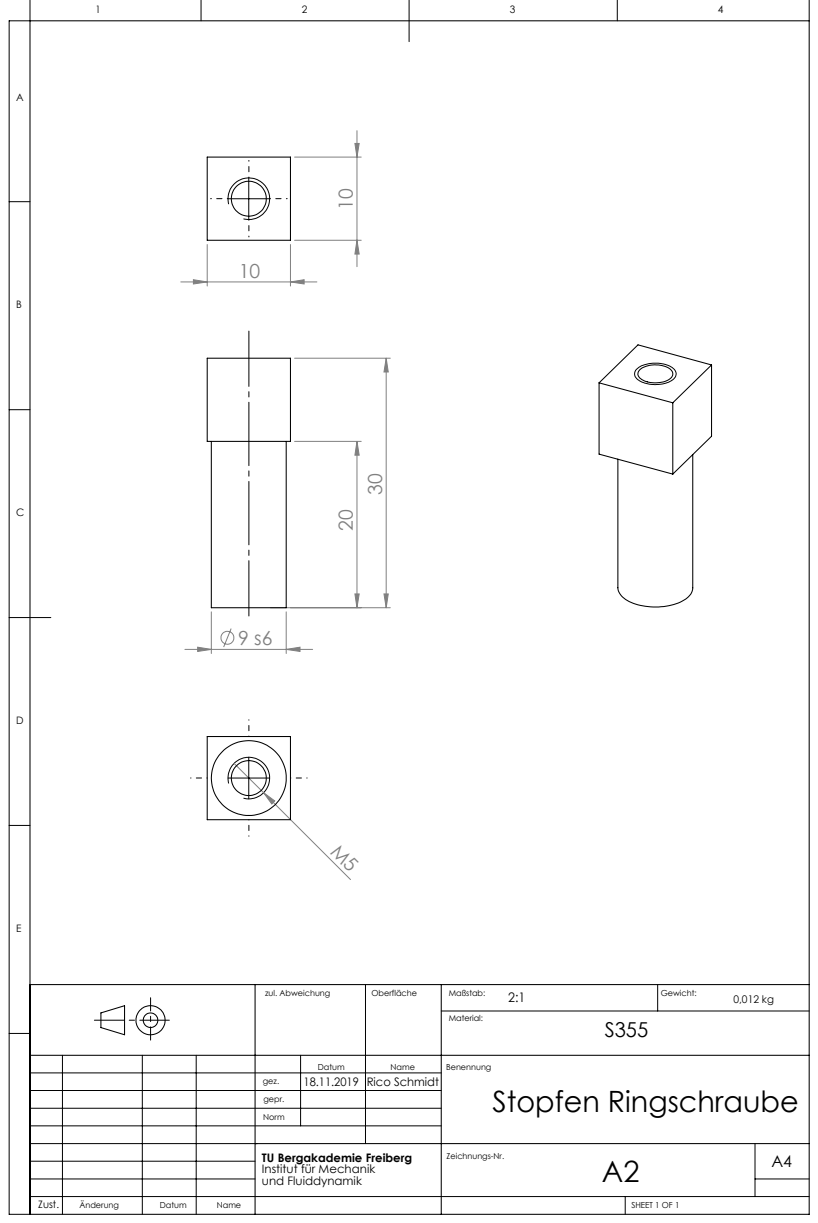
[picture p102: page 1]
zul. Abweichung; Gewicht:; SHEET 1 OF 1; Rico Schmidt; Stopfen Ringschraube

TU Bergakademie Freiberg
Institut für Mechanik
und Fluiddynamik
