sq43793911/Masterarbeit_public/Tex/Anhang/PDFs/Stopfen_Schaft_Ringschraube_Var2.PDF

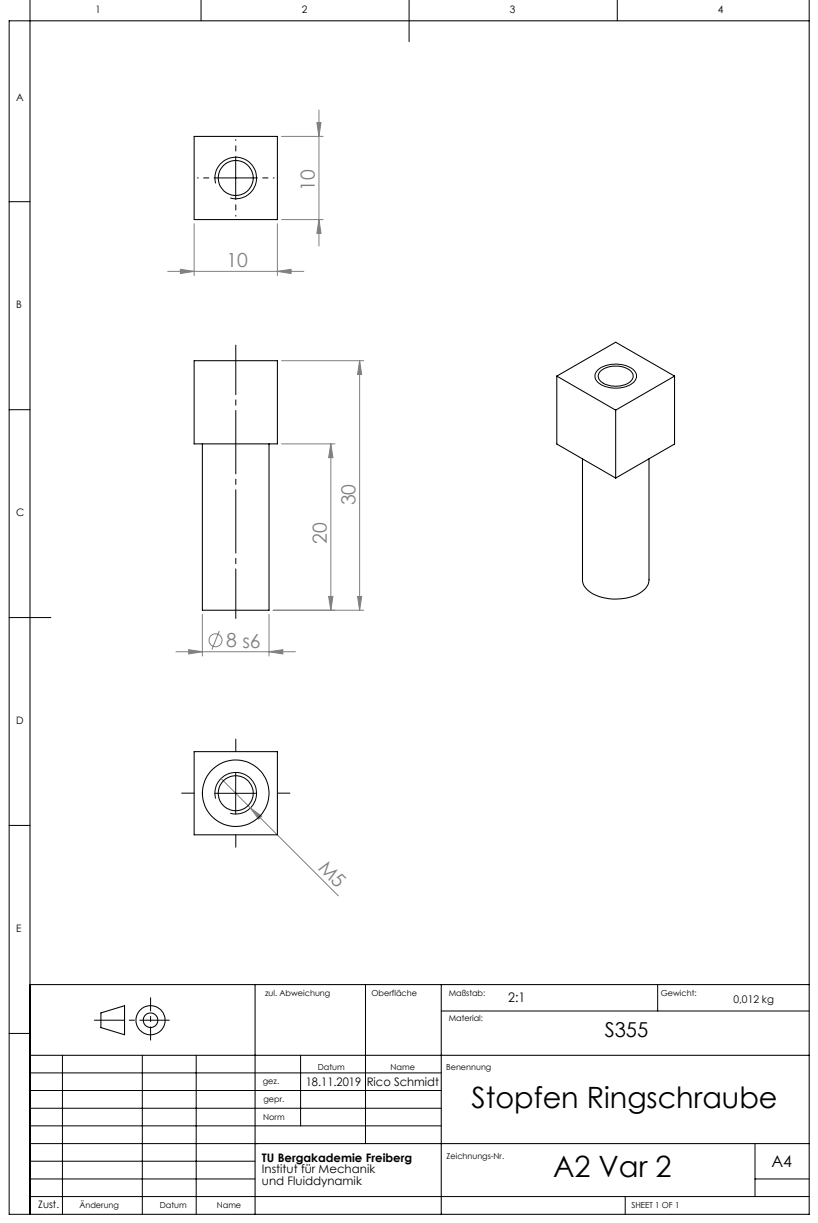
[picture p103: page 1]
Stopfen Ringschraube; A2 Var 2; zul. Abweichung; Gewicht:; SHEET 1 OF 1; Rico Schmidt

TU Bergakademie Freiberg
Institut für Mechanik
und Fluiddynamik
