sq43793911/Masterarbeit_public/(commit log)

2020-05-10 new update
    [Ergebnissen von Rico.xlsx, Ergebnissen_10_Mar.xlsx, Ergebnissen_18_Mar.xlsx, Ergebnissen_19_20_Feb.xlsx, ansys_probe_u.xlsx, ansys_probe_u_new.xlsx, ansys_probe_v.xlsx, ansys_probe_v_new.xlsx]
2020-05-10 name chaned
    [sta_mech_zug_biege_test_mk01-w.xlsx]
2020-07-21 finish update
    [Ergebnissen von Rico.xlsx, Ergebnissen_10_Mar.xlsx, Ergebnissen_18_Mar.xlsx, Ergebnissen_19_20_Feb.xlsx, Schaft_10x8.xlsx, Schaft_10x9.xlsx]
2020-08-10 Solidworks files updated
    [Schaft Ra10mm Ri8mm.SLDPRT, Schaft Ra10mm Ri9mm.SLDPRT, Schaft_10x8.SLDASM, Schaft_10x8.SLDDRW, Schaft_10x8_Ansys.SLDASM, Schaft_10x9.SLDASM, Schaft_10x9_Ansys.SLDASM, Stopfen Schaft Lagerung Var2.SLDPRT]
2020-09-01 files name changed
    [Ergebnissen von Rico.xlsx, Ergebnissen_10_Mar.xlsx, Ergebnissen_18_Mar.xlsx, Ergebnissen_19_20_Feb.xlsx, ansys_probe_u.xlsx, ansys_probe_u_new.xlsx, ansys_probe_v.xlsx, ansys_probe_v_new.xlsx]
2020-11-06 Tex files update
    [sta_mech_zug_biege_test_mk01-w.xlsx]
